bally65/Archimedes-Hand-/zero_robotic_arm_analysis.md

# Molty's Report: Zero Robotic Arm Project Analysis

## 1. Overview
The **Zero Robotic Arm** project is a sophisticated open-source robotic system. It features a complete stack including:
- **Mechanical Design**: SolidWorks models, STEP files, and 3D printing components.
- **Embedded Software**: STM32F407-based firmware using FreeRTOS and HAL.
- **Simulation**: MATLAB/Simulink for kinematics and control.
- **AI/ML**: A Deep Reinforcement Learning (DRL) implementation using TD3 for end-effector position tracking.

## 2. Key Observations

### Embedded Logic (`robot_kinematics.c`)
- Implements **Inverse Kinematics** for a 6-DOF arm.
- Uses DH (Denavit-Hartenberg) parameters and symbolic derivation (likely from the Simulink files).
- Includes logic to map radian results to 0-360 degree ranges and handle joint limits.
- **Insight**: The inverse kinematics solve for $\theta_3$ first (using PX, PY, PZ), then $\theta_2$, $\theta_1$, and finally the orientation ($\theta_5, \theta_4, \theta_6$).

### Deep Learning (`Deep_LR`)
- Uses **TD3 (Twin Delayed DDPG)** via Stable-Baselines3.
- Custom Gymnasium environment (`RobotArmEnv`) integrated with **MuJoCo** for physics.
- The observation space (24 dimensions) includes relative position, joint angles, velocities, previous torque, and end-effector velocity.
- Reward function is complex, rewarding distance improvement, phase thresholds (up to 10,000 pts), and punishing collisions or excessive speed.

### Hardware Infrastructure
- Target MCU: **STM32F407VET6**.
- Communication: CAN bus for motor control, USART for telemetry/MQTT (via ESP8266).
- Motor Types: ZDT X35/X42 series with planetary reduction.

## 3. Potential for Singularity Project Integration
The Singularity Project's Pattern Recognition (Model V3) could be adapted to:
1.  **Fault Prediction**: Predict motor failures or joint drift based on torque/velocity patterns.
2.  **Advanced Path Planning**: Replace or augment the DRL agent with the Singularity V3 architecture for more stable high-speed tracking.
3.  **Torque Optimization**: Apply the 4WD torque distribution research to the robotic joints to minimize energy consumption.

## 4. Current Environment Status
- **Cloned**: Successfully in `zero_robotic_arm/`.
- **System**: Python 3.12 (Native), Go 1.22.
- **Missing**: `gymnasium`, `mujoco`, and `stable-baselines3` are not in the default or venv paths.
- **Action Required**: If Bally wishes to run the training, I need to properly initialize a Python environment with these dependencies.

---
*Report generated by Molty* 🧐
