bally65/Archimedes-Hand-/5. Deep_LR/training_trend.png

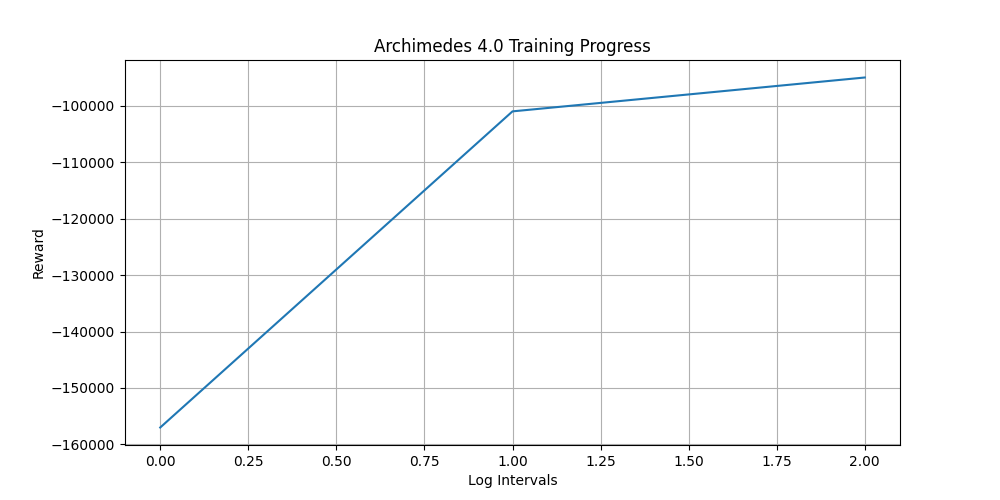
5. Deep_LR/training_trend.png
