bally65/Archimedes-Hand-/BOM.xlsx

序号 | 物料名称 | 规格 | 数量 | 备注 | 链接
1 | 行星减速器 | 51：1减速PLZ | 2 |  | https://item.taobao.com/item.htm?id=526104907428
2 | 行星减速器 | 27：1减速 输入6轴径 铣扁1mm | 1 |  | https://item.taobao.com/item.htm?id=526104907428
3 | STM32F407开发板 |  | 1 | 要求芯片为STM32F407，支持CAN协议 | https://item.taobao.com/item.htm?id=681246792404
4 | 42步进电机 | 42-40 身长40 | 2 |  | https://item.taobao.com/item.htm?id=673302946671&skuId=5032954871244
5 | 42行星减速步进电机 | 42HS4013 身长40 减速比50 | 1 |  | https://item.taobao.com/item.htm?id=21034340111&sku_properties=1627207%3A33214301305
6 | 35步进电机 | 35-28 | 1 |  | https://item.taobao.com/item.htm?id=723690490192
7 | 35行星减速步进电机 | 35-26 减速比51 | 2 |  | https://item.taobao.com/item.htm?id=581976167345
8 | 42步进电机驱动器 |  | 3 | 本项目目前仅支持张大头驱动器，需购买CAN协议模块 | https://item.taobao.com/item.htm?id=736578173538
9 | 35步进电机驱动器 |  | 3 | 本项目目前仅支持张大头驱动器，需购买CAN协议模块 | https://item.taobao.com/item.htm?id=736578173538
10 | 圆锥滚子轴承 | 20*37*12 | 1 |  | https://detail.tmall.com/item.htm?id=616787169746
11 | 十字扁平头螺丝 | M3*8 | 32 |  | https://detail.tmall.com/item.htm?id=641493636015
12 | 内六角螺丝圆柱头螺栓 | M5*14 | 4 |  | https://detail.tmall.com/item.htm?id=40189700729
13 | 内六角螺丝圆柱头螺栓 | M4*14 | 4 |  | https://detail.tmall.com/item.htm?id=40189700729
14 | 六角螺帽 | M5 | 4 |  | https://detail.tmall.com/item.htm?detail_redpacket_pop=true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
15 | 六角螺帽 | M3 | 2 |  | https://detail.tmall.com/item.htm?id=549640610734
16 | 土八热熔螺母 | M2*2*3 | 10 |  | https://detail.tmall.com/item.htm?id=809364062256
17 | 3M同步轮 | 3M25齿 孔8 宽11 | 2 |  | https://item.taobao.com/item.htm?id=739009813395
18 | 3M同步轮 | 3M25齿 孔5 宽11 | 3 |  | https://item.taobao.com/item.htm?id=739009813395
19 | 3M同步轮 | 3M25齿 孔6 宽11 | 1 |  | https://item.taobao.com/item.htm?id=739009813395
20 | 3M同步带 | 3M-长171-宽10 | 1 | 任意同步带淘宝店定制即可
21 | 3M同步带 | 3M-长177-宽10 | 2 | 任意同步带淘宝店定制即可
24 | 联轴器 | 外径28mm抱紧式联轴器 孔径8mm | 5 |  | https://detail.tmall.com/item.htm?id=667472622255
25 | 限位开关 | KW11-3Z-A | 3 |  | https://item.taobao.com/item.htm?id=630808292950
26 | 限位开关 | KW11-3Z-B | 2 |  | https://item.taobao.com/item.htm?id=630808292950
27 | 十字扁平头螺丝 | M2*8 | 10 |  | https://detail.tmall.com/item.htm?id=641493636015
28 | 张大头 步进闭环拓展板 |  | 1 |  | https://item.taobao.com/item.htm?ft=t&id=838884896678
29 | 不锈钢圆头螺丝 | M3*28 | 4 | 用来固定驱动器与35行星减速步进电机 | https://detail.tmall.com/item.htm?id=37753866337
30 | 内六角螺丝圆柱头螺栓 | M3*14 | 1 |  | https://detail.tmall.com/item.htm?id=40189700729
