bally65/Archimedes-Hand-/1. Model/3d_printing_all.3mf

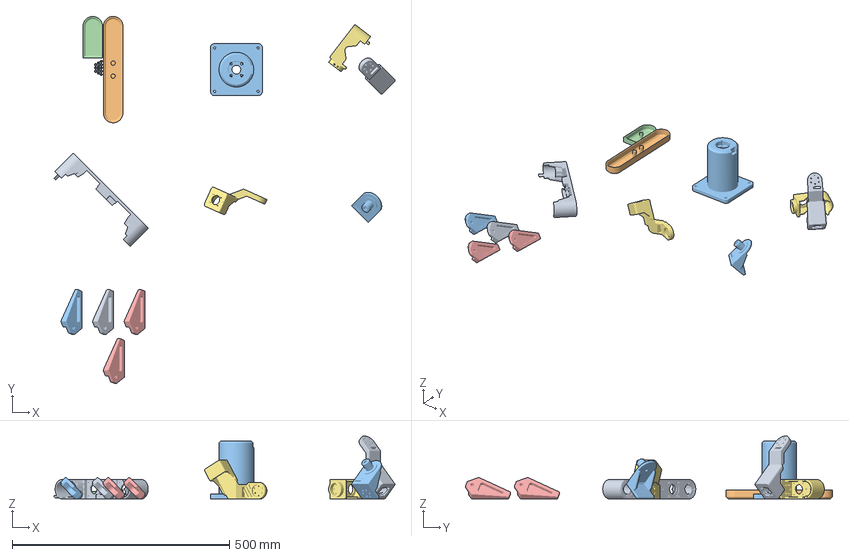
[picture p7: CAD file, 2026-02-07]
1. Model/3d_printing_all.3mf
785.0 x 845.2 x 145.0 mm
frame2.STEP
外壳1.step
frame0^ZERO_ARM.STEP
外壳2.STEP
底座固定爪^XG_Robot_Arm.STEP x 4
1mm垫片.STEP x 12
frame4.STEP
frame3.STEP
frame5.STEP
frame1.STEP
