bally65/Archimedes-Hand-/1. Model/STEP/单轴行星减速器35-38.step

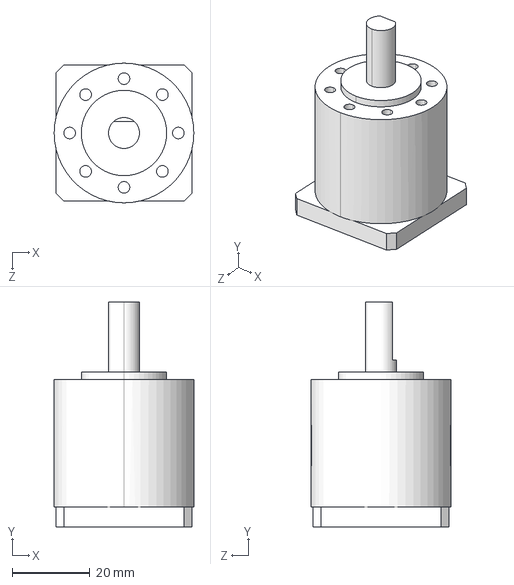
[picture p8: CAD file, 2026-02-07]
1. Model/STEP/单轴行星减速器35-38.step
36.0 x 58.0 x 36.0 mm
