bally65/Archimedes-Hand-/1. Model/STL/base_plate_optimized.stl

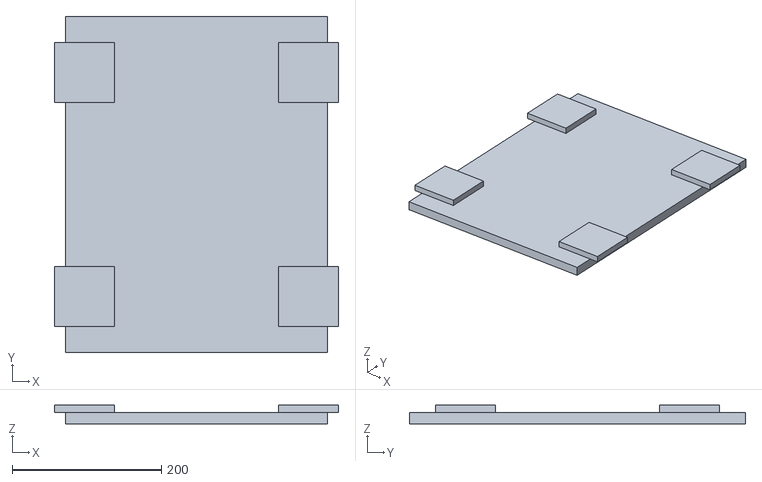
[picture p9: CAD file, 2026-02-11]
1. Model/STL/base_plate_optimized.stl
380.0 x 450.0 x 25.0
