bally65/Archimedes-Hand-/3. Simulink/model_v1.1/URDF_XG_Robot_Arm_Urdf_V1.1/meshes/link3.STL

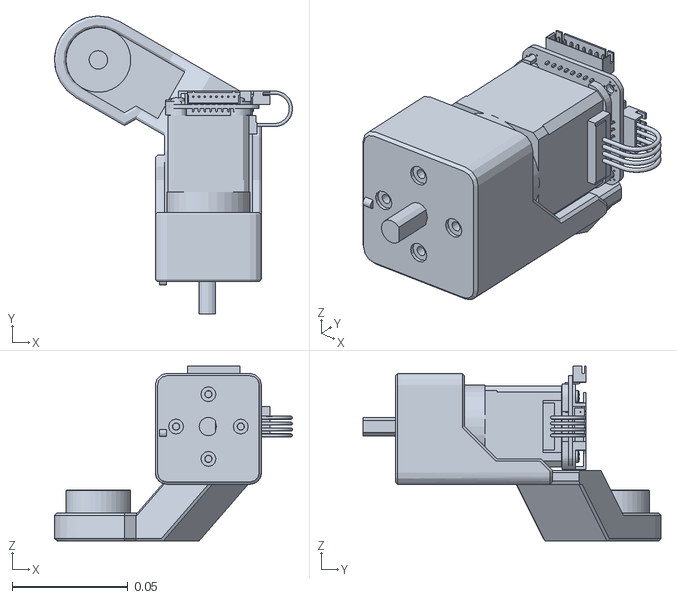
[picture p10: CAD file, 2026-02-07]
3. Simulink/model_v1.1/URDF_XG_Robot_Arm_Urdf_V1.1/meshes/link3.STL
0.103 x 0.129 x 0.0757
