bally65/Archimedes-Hand-/3. Simulink/model_v1.1/URDF同步轮M3-05.SLDPRT

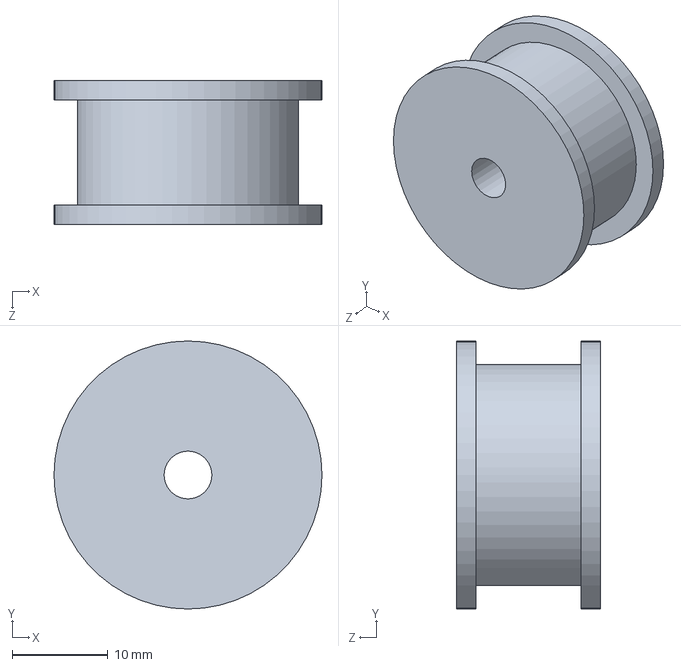
[picture p11: CAD file, 2026-02-07]
3. Simulink/model_v1.1/URDF同步轮M3-05.SLDPRT
28.0 x 28.0 x 15.0 mm
