bally65/Archimedes-Hand-/3. Simulink/URDF_XG_Robot_Arm_Urdf_V1_1/meshes/ee_link.STL

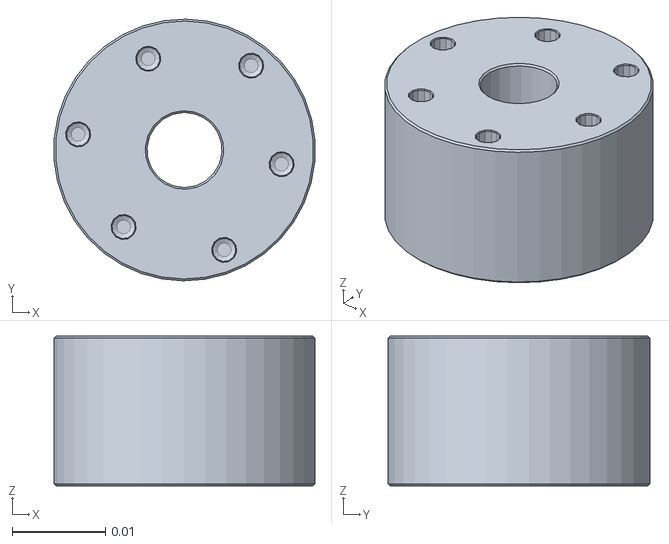
[picture p12: CAD file, 2026-02-07]
3. Simulink/URDF_XG_Robot_Arm_Urdf_V1_1/meshes/ee_link.STL
0.0279 x 0.028 x 0.016
