bally65/Archimedes-Hand-/1. Model/STEP/限位开关_按下_长柄.step

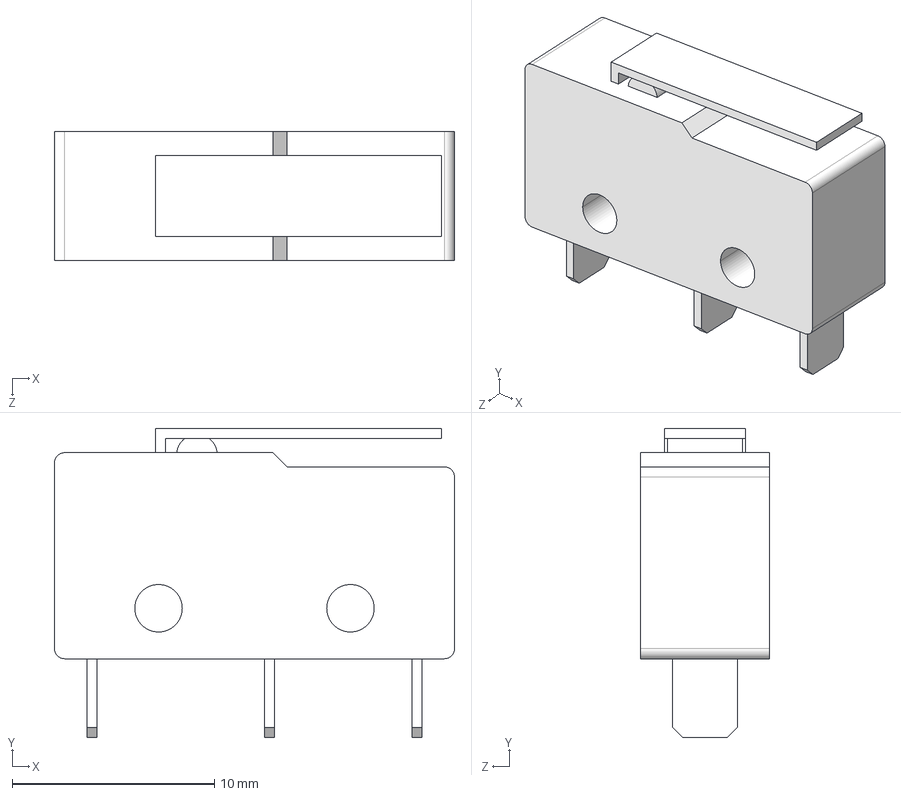
[picture p13: CAD file, 2026-02-07]
1. Model/STEP/限位开关_按下_长柄.step
19.8 x 15.3 x 6.40 mm
