bally65/Archimedes-Hand-/3. Simulink/model_v1.1/URDF_XG_Robot_Arm_Urdf_V1.1/meshes/link1.STL

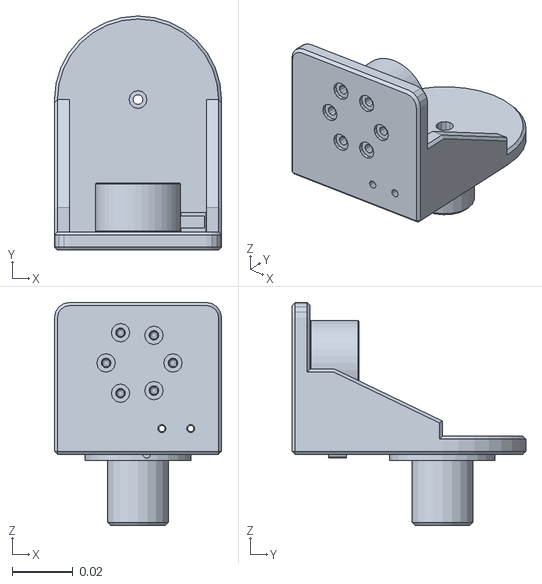
[picture p14: CAD file, 2026-02-07]
3. Simulink/model_v1.1/URDF_XG_Robot_Arm_Urdf_V1.1/meshes/link1.STL
0.055 x 0.077 x 0.0734
