bally65/Archimedes-Hand-/3. Simulink/model_v1.1/URDFframe5.SLDPRT

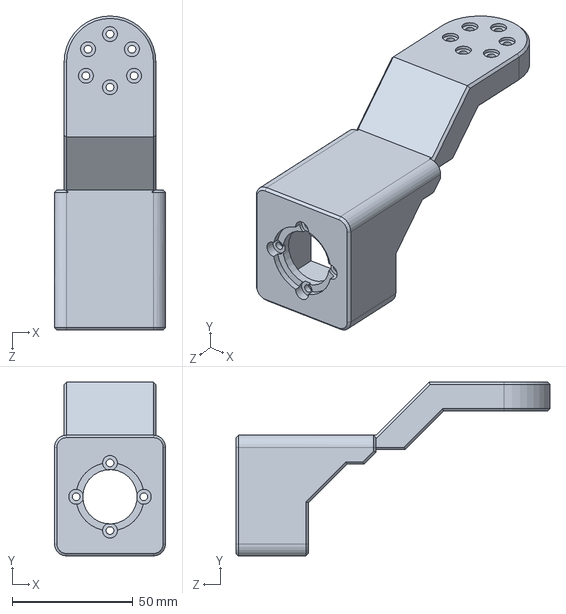
[picture p15: CAD file, 2026-02-07]
3. Simulink/model_v1.1/URDFframe5.SLDPRT
46.0 x 72.0 x 130.0 mm
