bally65/Archimedes-Hand-/3. Simulink/URDF_XG_Robot_Arm_Urdf_V1_1/meshes/link4.STL

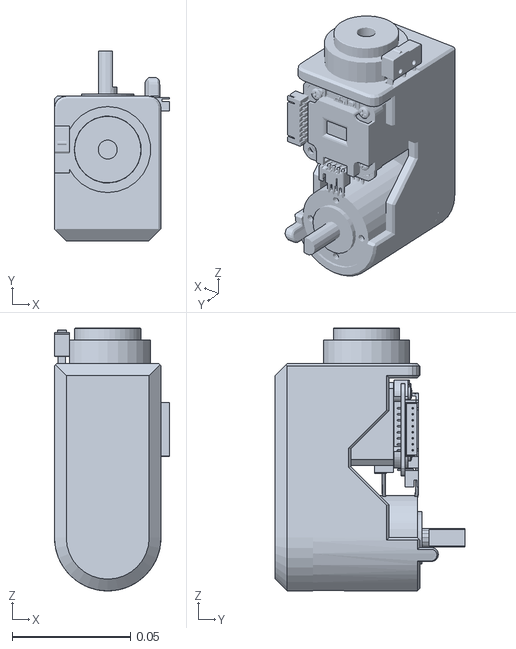
[picture p16: CAD file, 2026-02-07]
3. Simulink/URDF_XG_Robot_Arm_Urdf_V1_1/meshes/link4.STL
0.0487 x 0.08 x 0.111
