bally65/Archimedes-Hand-/1. Model/STL/base_plate.stl

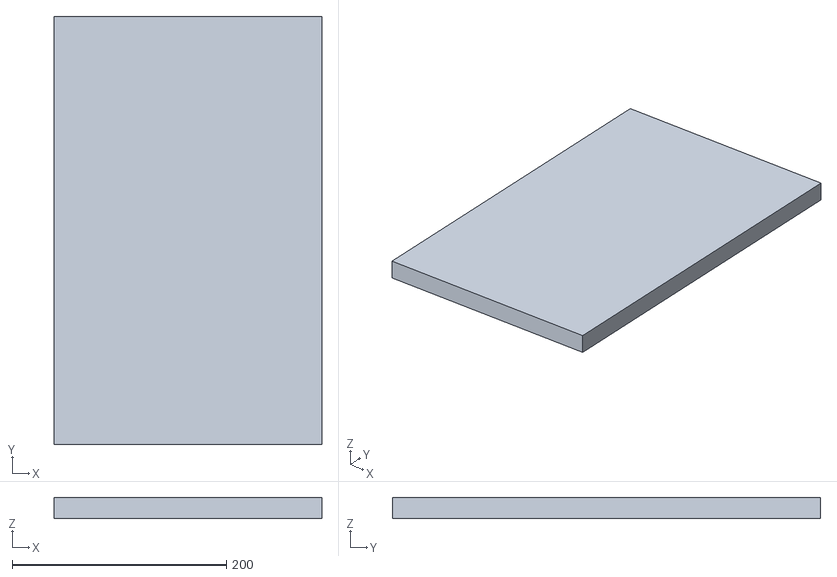
[picture p17: CAD file, 2026-02-08]
1. Model/STL/base_plate.stl
250.0 x 400.0 x 20.0
