bally65/Archimedes-Hand-/3. Simulink/model_v1.1/URDF外壳2.SLDPRT

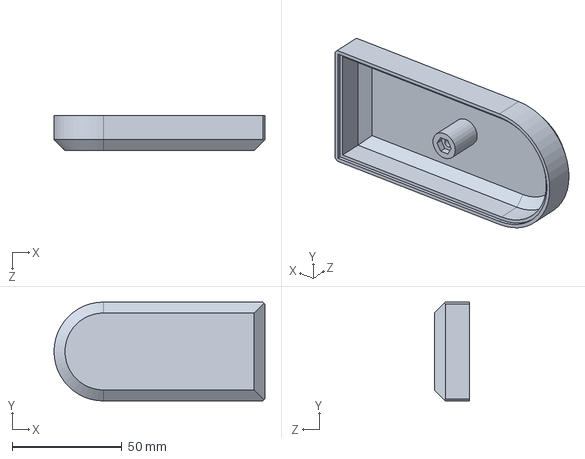
[picture p18: CAD file, 2026-02-07]
3. Simulink/model_v1.1/URDF外壳2.SLDPRT
96.0 x 45.0 x 16.0 mm
