bally65/Archimedes-Hand-/3. Simulink/URDF_XG_Robot_Arm_Urdf_V1_1/meshes/link5.STL

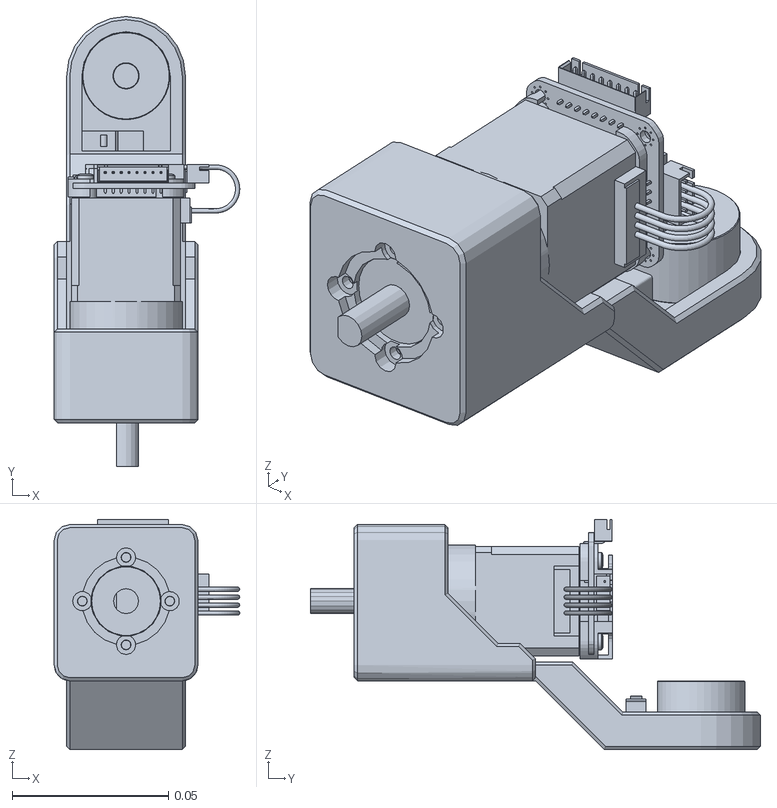
[picture p19: CAD file, 2026-02-07]
3. Simulink/URDF_XG_Robot_Arm_Urdf_V1_1/meshes/link5.STL
0.0594 x 0.144 x 0.0737
