bally65/Archimedes-Hand-/1. Model/STEP/frame5.step

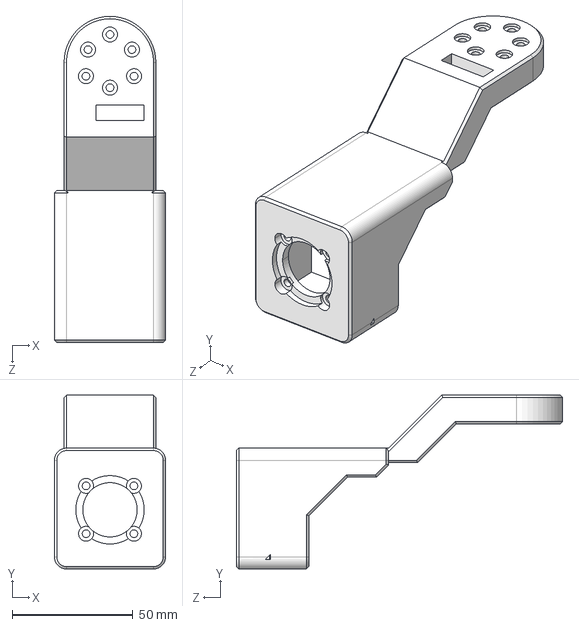
[picture p20: CAD file, 2026-02-07]
1. Model/STEP/frame5.step
46.0 x 72.0 x 135.0 mm
