bally65/Archimedes-Hand-/3. Simulink/model_v1.1/URDFframe4.SLDPRT

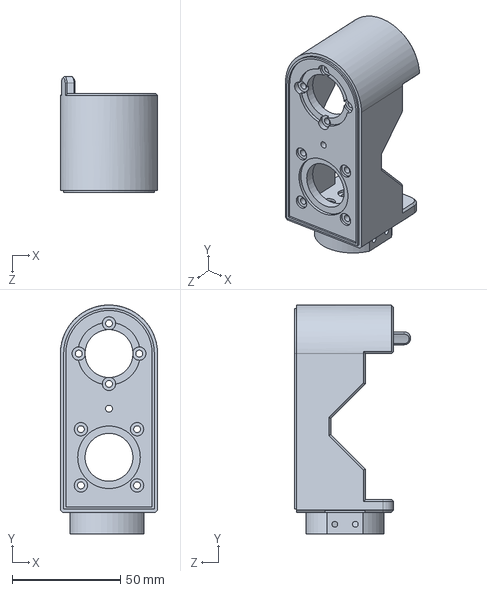
[picture p21: CAD file, 2026-02-07]
3. Simulink/model_v1.1/URDFframe4.SLDPRT
45.0 x 106.0 x 53.9 mm
