bally65/Archimedes-Hand-/1. Model/STEP/1mm垫片.STEP

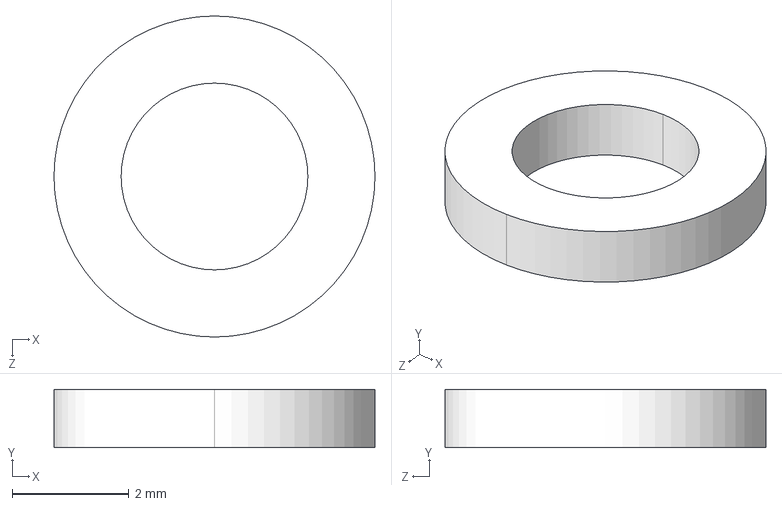
[picture p22: CAD file, 2026-02-07]
1. Model/STEP/1mm垫片.STEP
5.50 x 1.00 x 5.50 mm
