bally65/Archimedes-Hand-/3. Simulink/model_v1.1/URDFframe2.SLDPRT

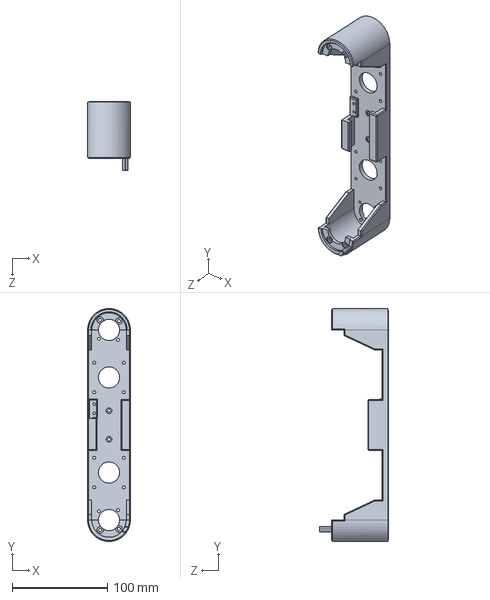
[picture p23: CAD file, 2026-02-07]
3. Simulink/model_v1.1/URDFframe2.SLDPRT
45.0 x 245.0 x 73.0 mm
