bally65/Archimedes-Hand-/1. Model/STEP/外壳2.step

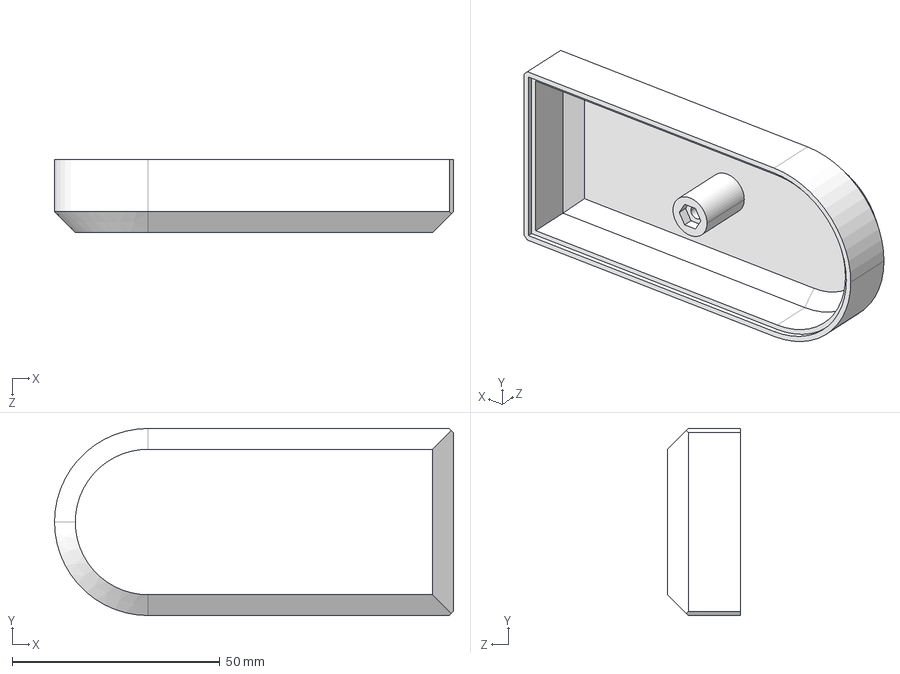
[picture p24: CAD file, 2026-02-07]
1. Model/STEP/外壳2.step
96.0 x 45.0 x 17.5 mm
