bally65/Archimedes-Hand-/3. Simulink/model_v1.1/URDF热熔螺母.SLDPRT

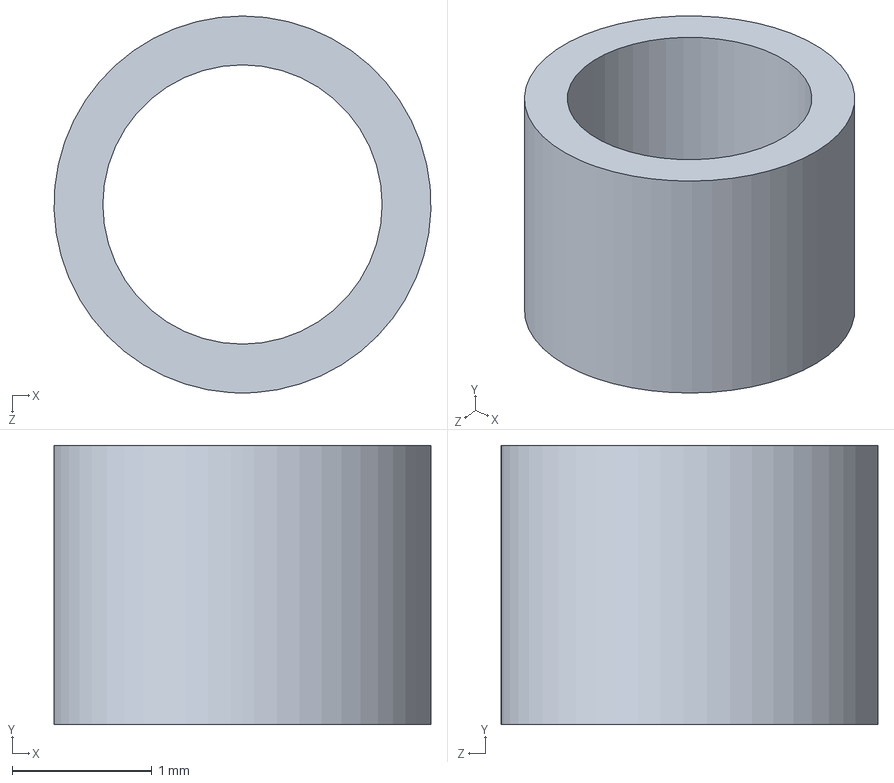
[picture p25: CAD file, 2026-02-07]
3. Simulink/model_v1.1/URDF热熔螺母.SLDPRT
2.70 x 2.00 x 2.70 mm
