bally65/Archimedes-Hand-/1. Model/STEP/底座固定爪.step

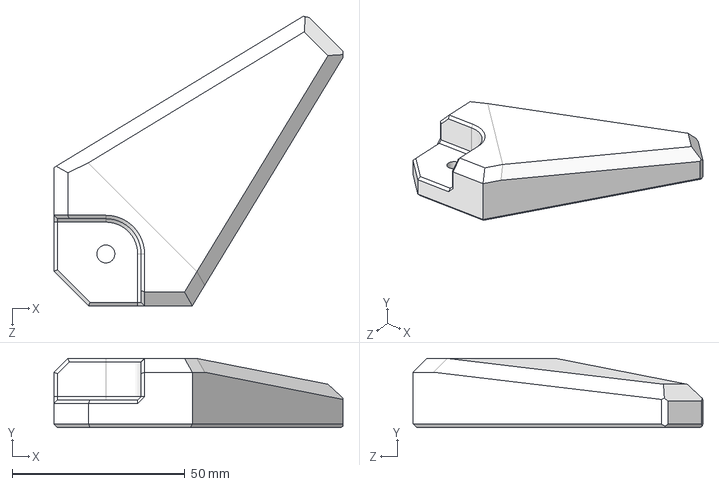
[picture p26: CAD file, 2026-02-07]
1. Model/STEP/底座固定爪.step
83.6 x 20.0 x 83.8 mm
