bally65/Archimedes-Hand-/1. Model/STEP/限位开关_按下_0.8mm.step

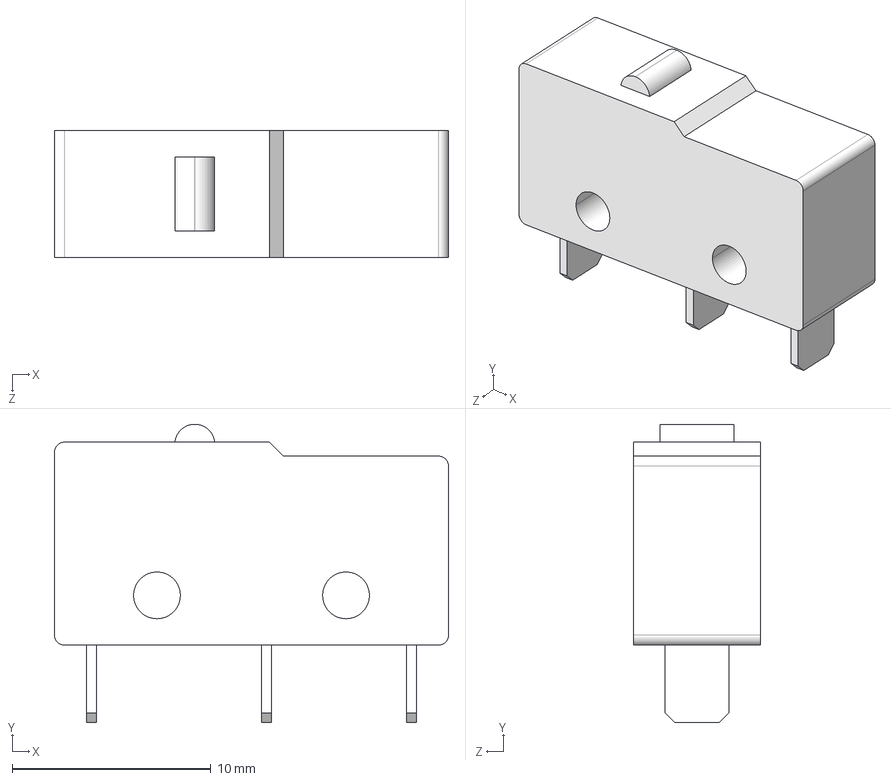
[picture p27: CAD file, 2026-02-07]
1. Model/STEP/限位开关_按下_0.8mm.step
19.8 x 15.0 x 6.40 mm
