bally65/Archimedes-Hand-/1. Model/STEP/ZDT_X42_L40Motor.step

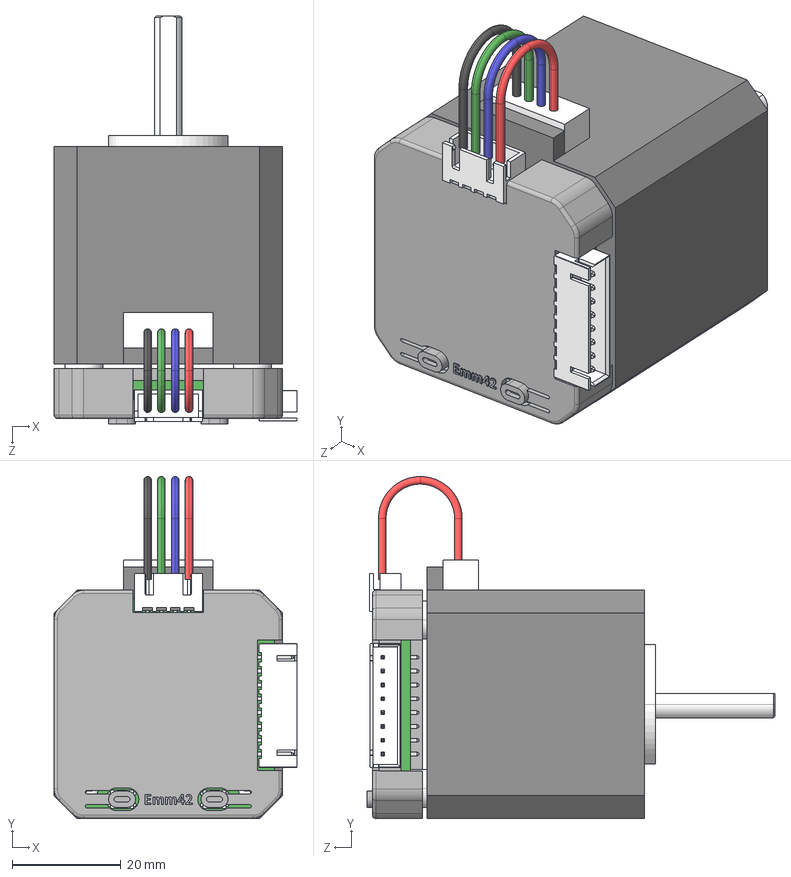
[picture p29: CAD file, 2026-02-07]
1. Model/STEP/ZDT_X42_L40Motor.step
44.7 x 62.9 x 75.0 mm
ts-1145a-b-a_White.step.STEP x 2
User_Library-XH2_54-4P-AW.step.STEP
XH2.54-8P_H-0.step.STEP
Extruded.step.STEP
Extruded-1.step.STEP
42_STEPPER_MOTOR.STEP
SHIM_3x7x3.STEP x 4
M3x6mm_Phillips.STEP x 4
ZDT_X42_V1.2.STEP
WIRE_2.54.STEP
