bally65/Archimedes-Hand-/3. Simulink/model_v1.1/URDF外壳1.SLDPRT

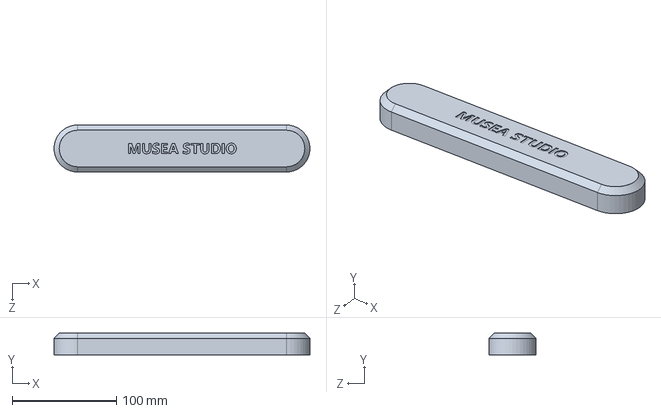
[picture p30: CAD file, 2026-02-07]
3. Simulink/model_v1.1/URDF外壳1.SLDPRT
245.0 x 21.0 x 45.0 mm
