bally65/Archimedes-Hand-/1. Model/STEP/双轴行星减速器36-38.step

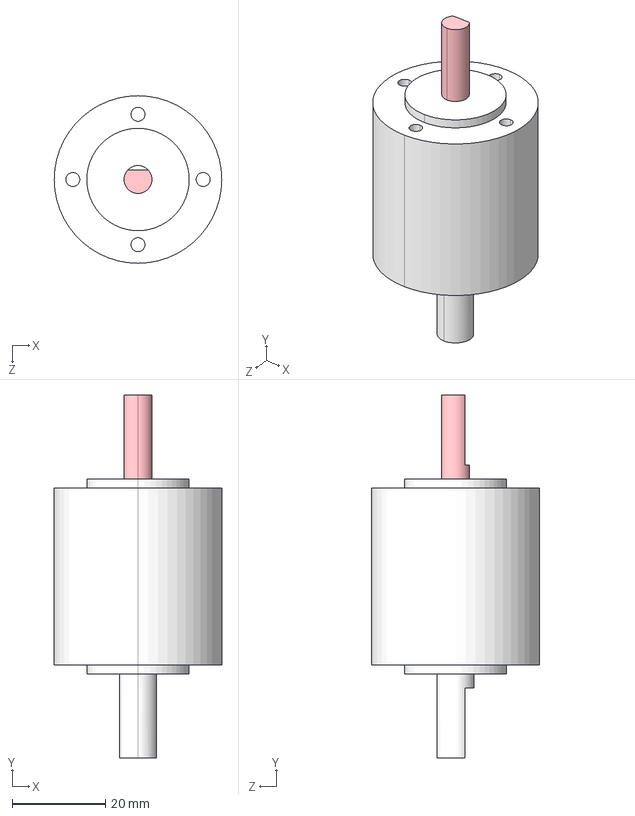
[picture p31: CAD file, 2026-02-07]
1. Model/STEP/双轴行星减速器36-38.step
36.0 x 78.0 x 36.0 mm
