bally65/Archimedes-Hand-/3. Simulink/model_v1.1/URDF单轴行星减速器35-38.SLDPRT

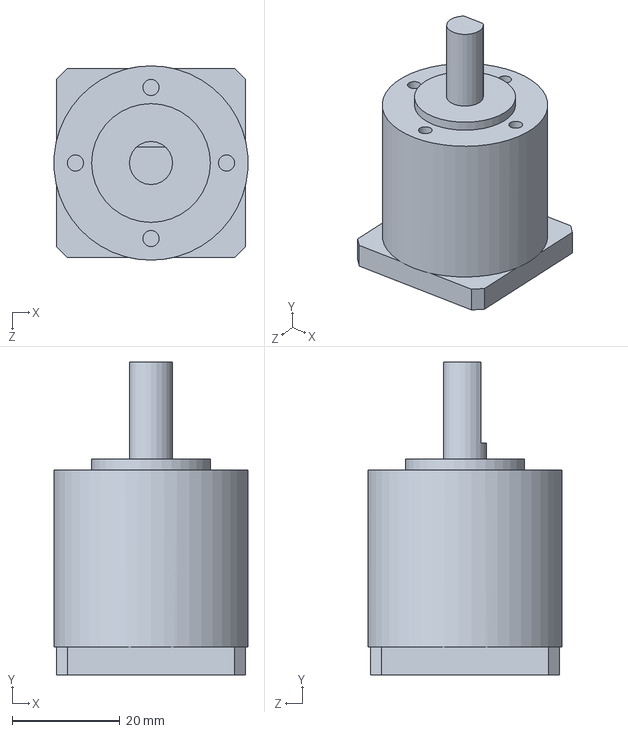
[picture p32: CAD file, 2026-02-07]
3. Simulink/model_v1.1/URDF单轴行星减速器35-38.SLDPRT
35.9 x 58.0 x 36.0 mm
