bally65/Archimedes-Hand-/1. Model/STEP/frame0^ZERO_ARM.STEP

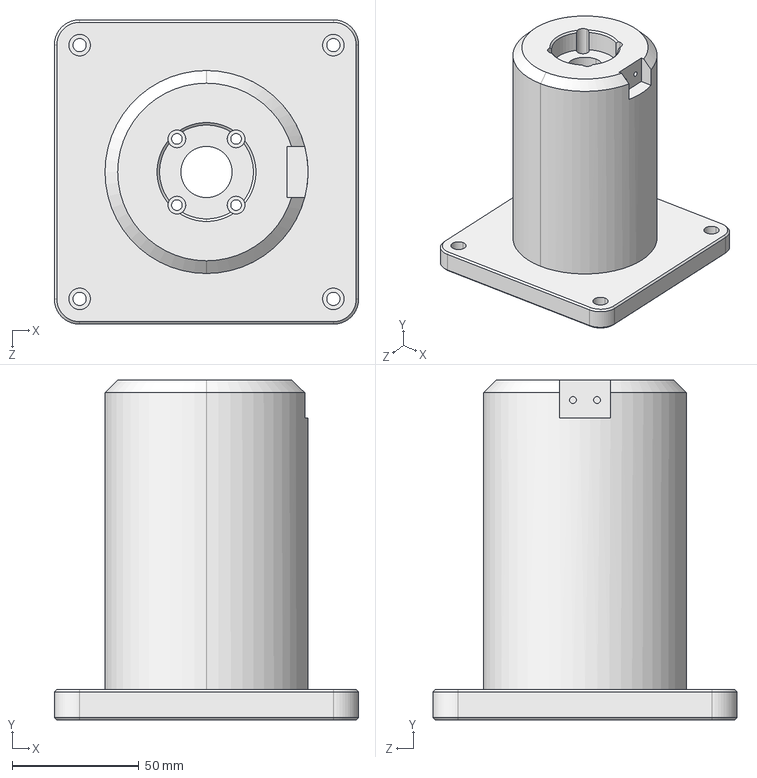
[picture p33: CAD file, 2026-02-07]
1. Model/STEP/frame0^ZERO_ARM.STEP
120.0 x 134.0 x 120.0 mm
