bally65/Archimedes-Hand-/1. Model/STEP/42XG二级减速.step

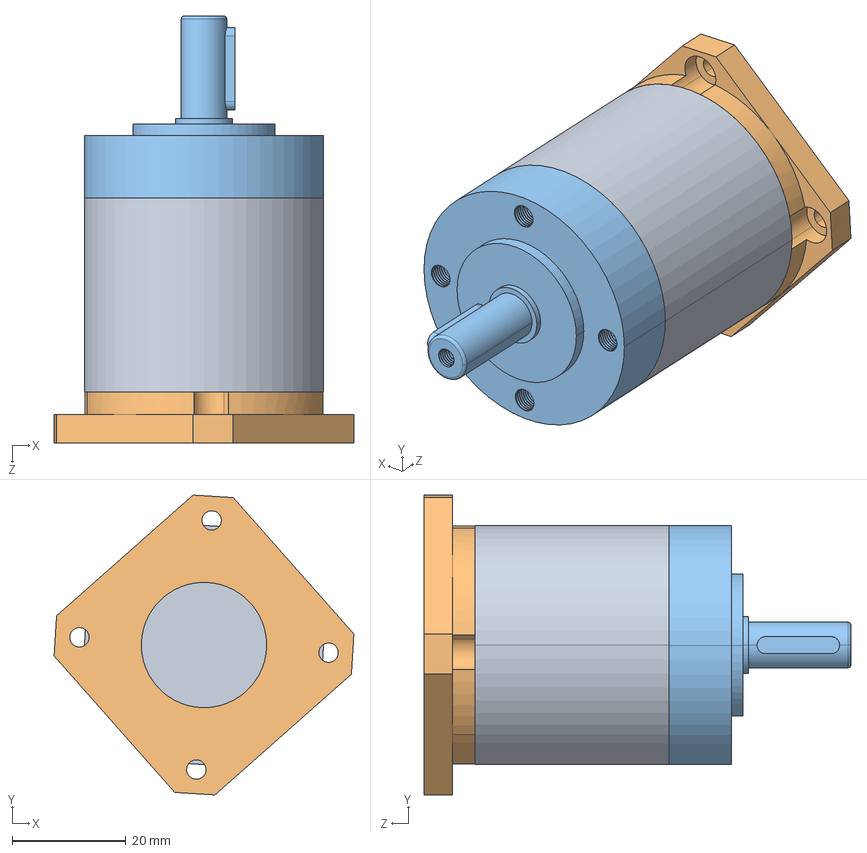
[picture p34: CAD file, 2026-02-07]
1. Model/STEP/42XG二级减速.step
52.7 x 52.7 x 75.0 mm
42XG____.STEP
42XG______.STEP
42XG______-0.STEP
