bally65/Archimedes-Hand-/3. Simulink/model_v1.1/URDFframe3.SLDPRT

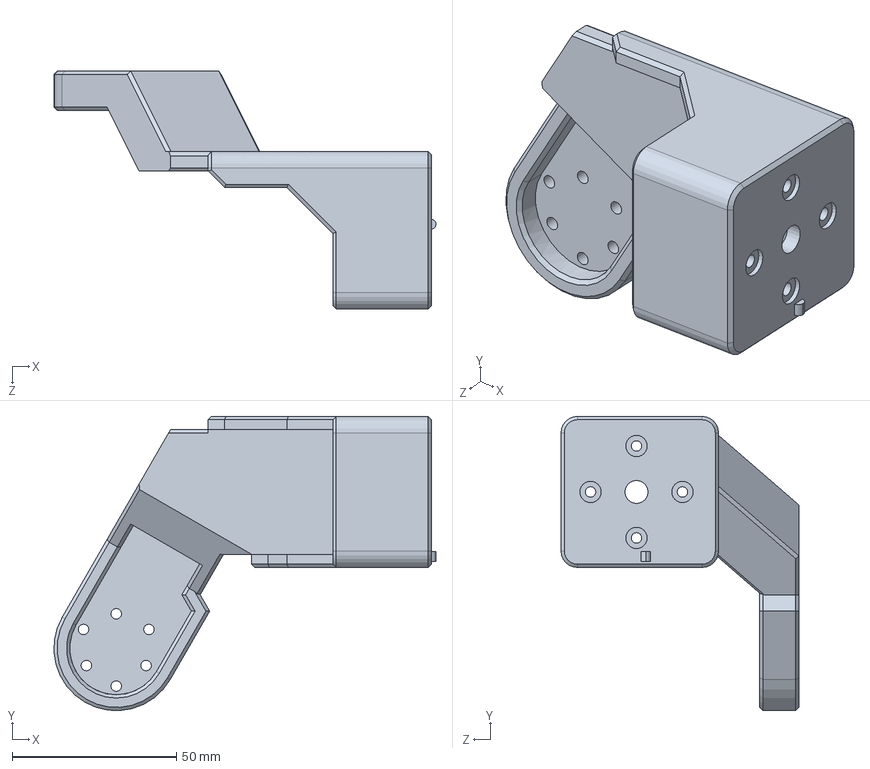
[picture p35: CAD file, 2026-02-07]
3. Simulink/model_v1.1/URDFframe3.SLDPRT
116.4 x 89.6 x 72.5 mm
