bally65/Archimedes-Hand-/1. Model/STEP/frame2.step

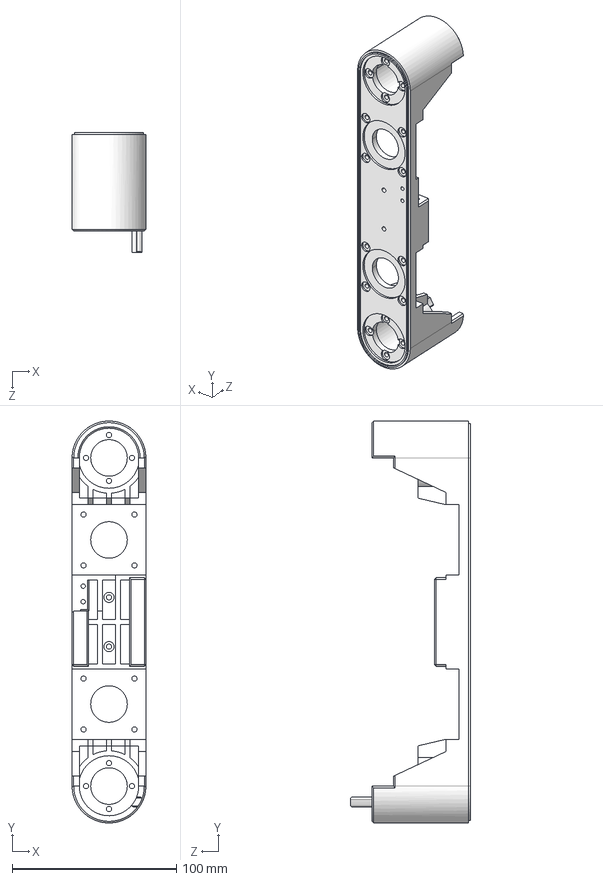
[picture p36: CAD file, 2026-02-07]
1. Model/STEP/frame2.step
45.0 x 245.0 x 73.0 mm
