bally65/Archimedes-Hand-/3. Simulink/model_v1.1/URDF双轴行星减速器36-38.SLDPRT

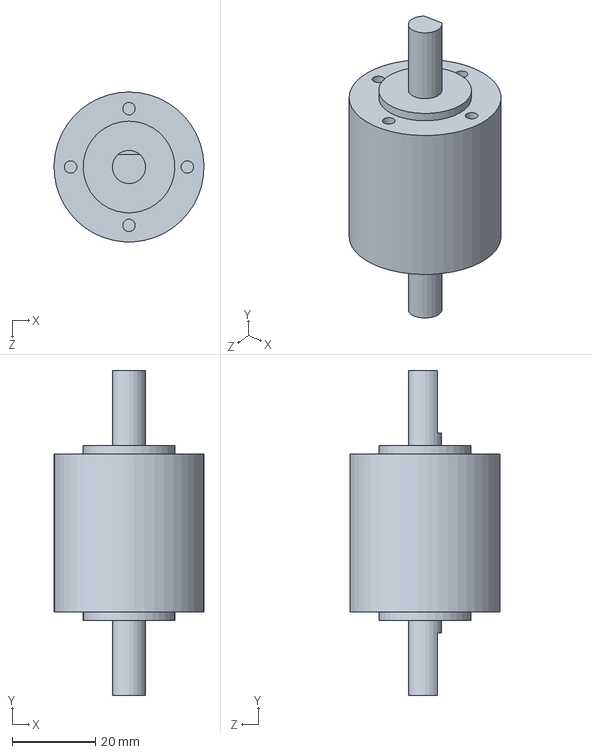
[picture p37: CAD file, 2026-02-07]
3. Simulink/model_v1.1/URDF双轴行星减速器36-38.SLDPRT
36.0 x 78.0 x 36.0 mm
