bally65/Archimedes-Hand-/3. Simulink/model_v1.1/URDFframe1.SLDPRT

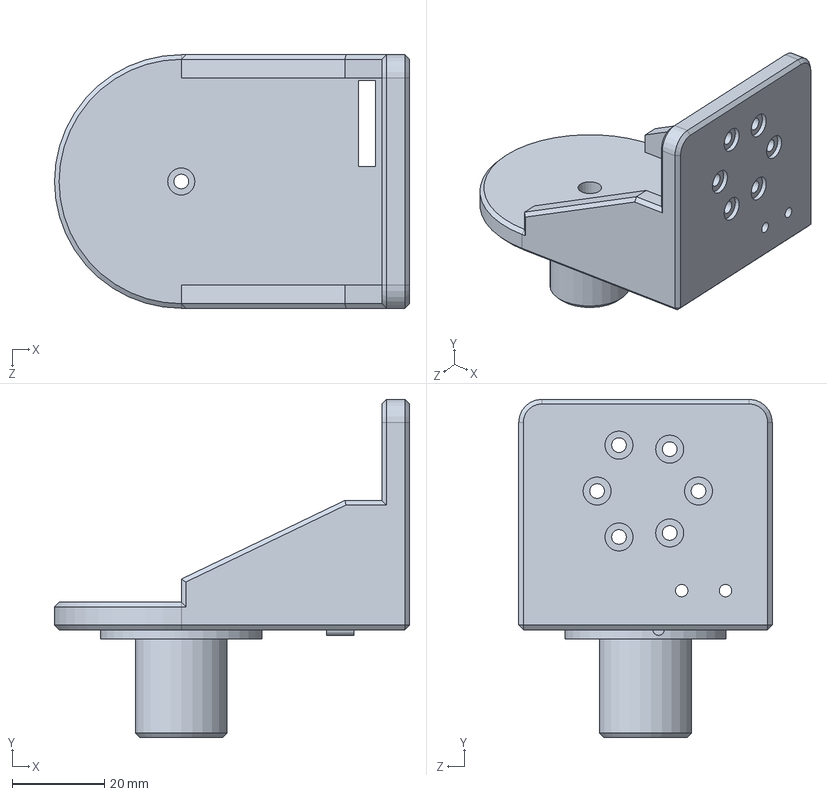
[picture p38: CAD file, 2026-02-07]
3. Simulink/model_v1.1/URDFframe1.SLDPRT
77.0 x 73.4 x 55.0 mm
