bally65/Archimedes-Hand-/1. Model/STEP/轴直径8mm_抱紧式联轴器(客户图）.step

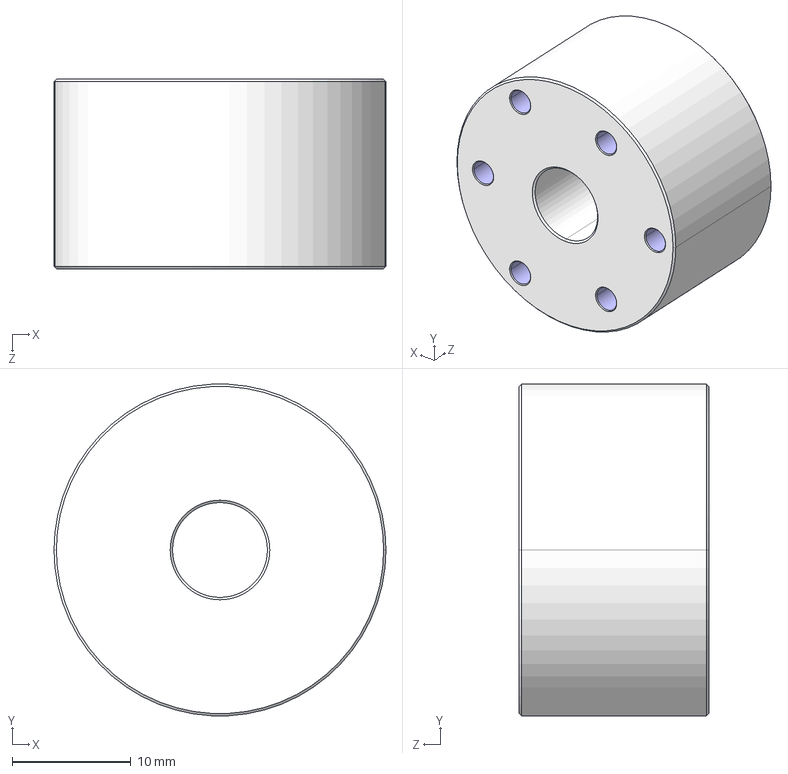
[picture p39: CAD file, 2026-02-07]
1. Model/STEP/轴直径8mm_抱紧式联轴器(客户图）.step
28.0 x 28.0 x 16.0 mm
