bally65/Archimedes-Hand-/1. Model/STEP/frame1.step

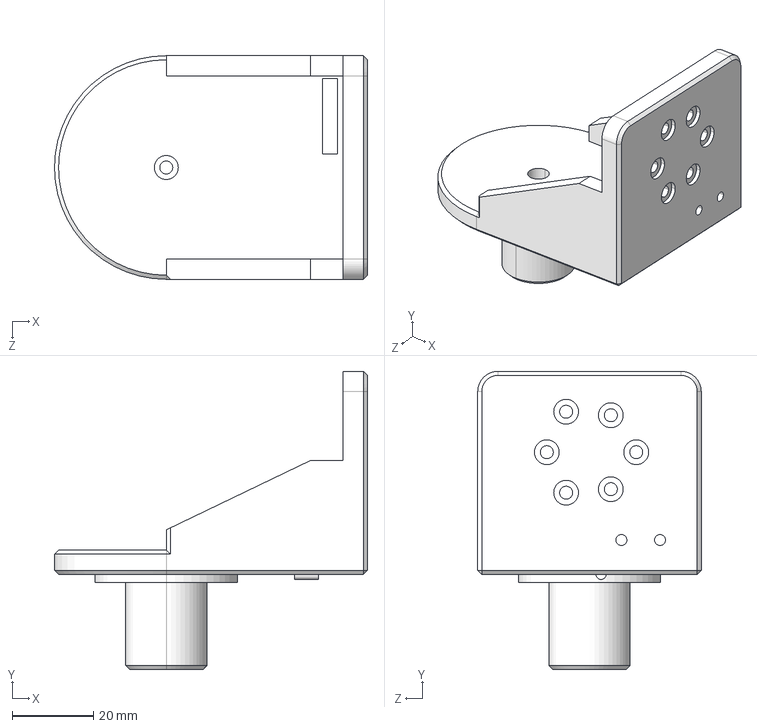
[picture p40: CAD file, 2026-02-07]
1. Model/STEP/frame1.step
77.0 x 73.4 x 55.0 mm
