bally65/Archimedes-Hand-/1. Model/STEP/手机夹具.step

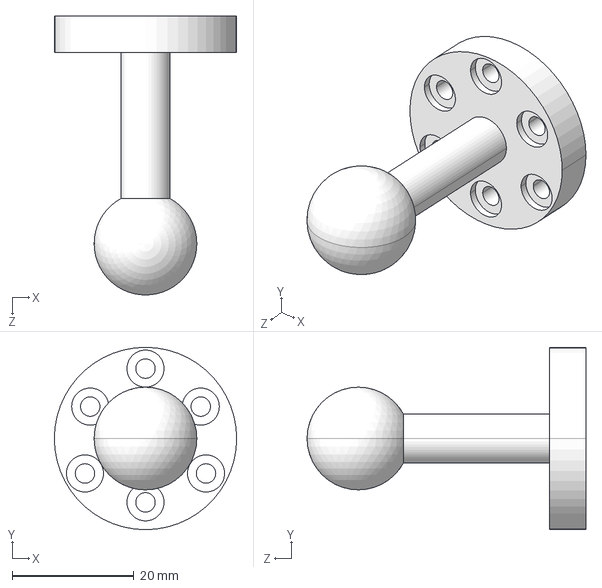
[picture p41: CAD file, 2026-02-07]
1. Model/STEP/手机夹具.step
30.0 x 30.0 x 45.9 mm
