bally65/Archimedes-Hand-/1. Model/STEP/ZDT_X35_L28Motor.step

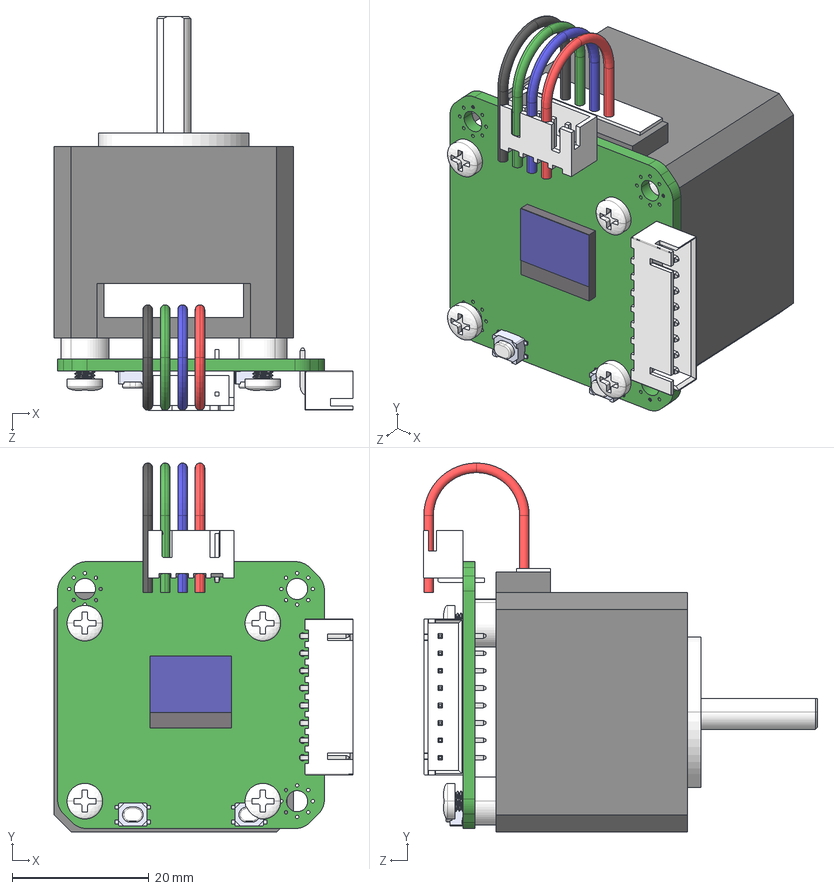
[picture p42: CAD file, 2026-02-07]
1. Model/STEP/ZDT_X35_L28Motor.step
43.7 x 53.9 x 57.6 mm
User_Library-XH2_54-4P-AW.step.STEP
ts-1145a-b-a_White.step.STEP x 2
Extruded.step.STEP
Extruded-1.step.STEP
XH2.54-8P_H-0.step.STEP
35_STEPPER_MOTOR.STEP
SHIM_3x7x3.STEP x 4
M3x6mm_Phillips.STEP x 4
WIRE_2.54.STEP
