bally65/Archimedes-Hand-/1. Model/STEP/frame3.step

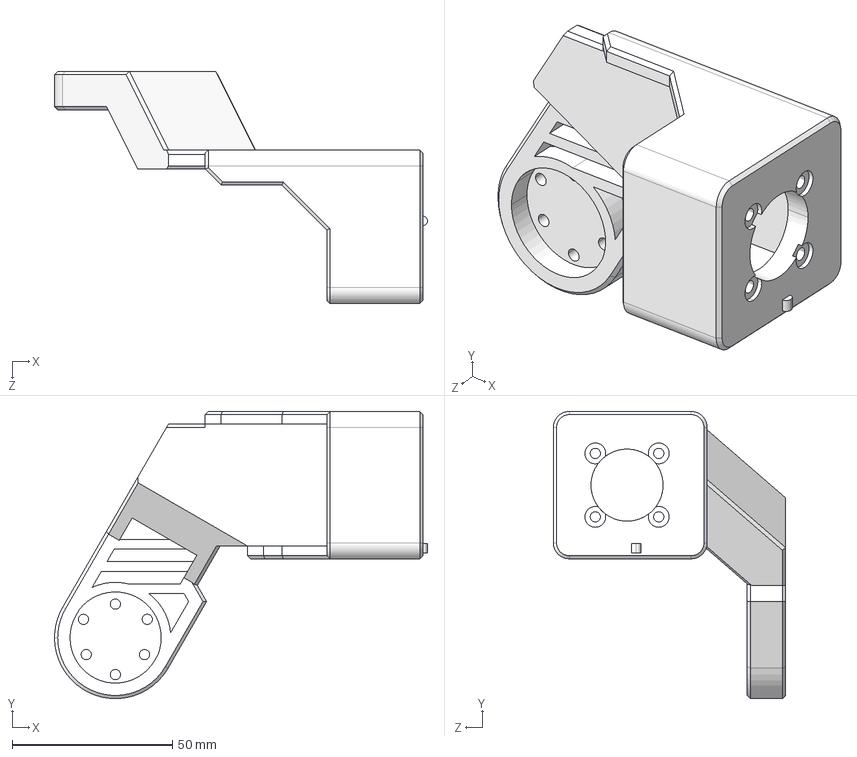
[picture p43: CAD file, 2026-02-07]
1. Model/STEP/frame3.step
116.4 x 89.6 x 72.5 mm
