bally65/Archimedes-Hand-/3. Simulink/model_v1.1/URDFZDT_X42_L40Motor.SLDASM

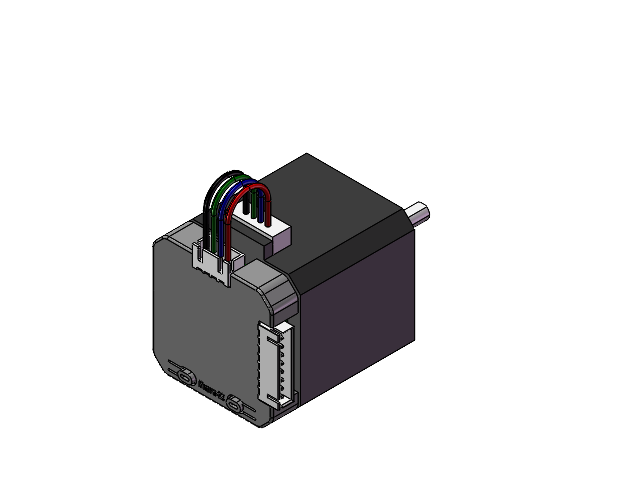
[picture p44: CAD file, 2026-02-07]
3. Simulink/model_v1.1/URDFZDT_X42_L40Motor.SLDASM
ts-1145a-b-a_White.step^Next.step_ZDT_X35_V1.2_PCB.step_ZDT_X35_L28Motor_URDFZDT_X35_L28Motor
User_Library-XH2_54-4P-AW.step^J6.step_ZDT_X35_V1.2_PCB.step_ZDT_X35_L28Motor_URDFZDT_X35_L28Motor
XH2.54-8P_H-0.step^XH2.54-8P_H.step_J3.step_ZDT_X35_V1.2_PCB.step_ZDT_X35_L28Motor_URDFZDT_X35_L28Motor
Extruded.step^6308926992.step_J1.step_ZDT_X35_V1.2_PCB.step_ZDT_X35_L28Motor_URDFZDT_X35_L28Motor
Extruded-1.step^6308926832.step_J1.step_ZDT_X35_V1.2_PCB.step_ZDT_X35_L28Motor_URDFZDT_X35_L28Motor
ts-1145a-b-a_White.step^Enter.step_ZDT_X35_V1.2_PCB.step_ZDT_X35_L28Motor_URDFZDT_X35_L28Motor
42_STEPPER_MOTOR^ZDT_X42_L40Motor_URDFZDT_X42_L40Motor
SHIM_3x7x3^ZDT_X35_L28Motor_URDFZDT_X35_L28Motor x 4
M3x6mm_Phillips^ZDT_X35_L28Motor_URDFZDT_X35_L28Motor x 4
ZDT_X42_V1.2^ZDT_X42_L40Motor_URDFZDT_X42_L40Motor
WIRE_2.54^ZDT_X35_L28Motor_URDFZDT_X35_L28Motor
