bally65/Archimedes-Hand-/3. Simulink/model_v1.1/URDF42XG二级减速.SLDASM

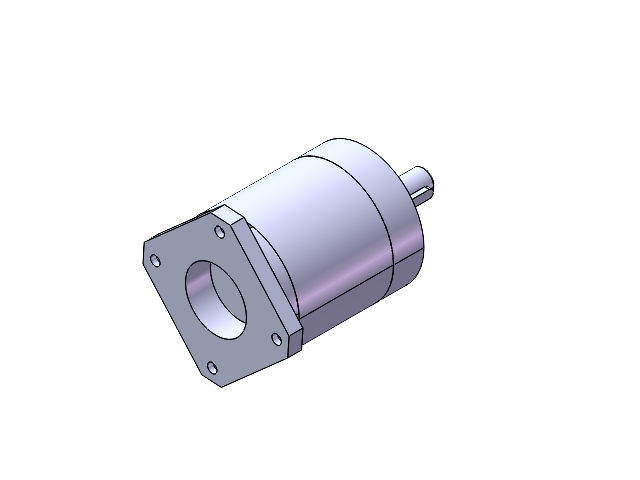
[picture p45: CAD file, 2026-02-07]
3. Simulink/model_v1.1/URDF42XG二级减速.SLDASM
42XG____^42XG二级减速_URDF42XG二级减速
42XG______^42XG二级减速_URDF42XG二级减速
42XG______-0^42XG二级减速_URDF42XG二级减速
