bally65/Archimedes-Hand-/(list of files, cad)

Other CAD files:
1. Model/STEP/同步轮M3-06.step
3. Simulink/model_v1.1/URDF_XG_Robot_Arm_Urdf_V1.1/meshes/link4.STL
1. Model/STEP/同步轮M3-05.step
3. Simulink/model_v1.1/URDF_XG_Robot_Arm_Urdf_V1.1/meshes/link5.STL
3. Simulink/model_v1.1/URDF同步轮M3-06.SLDPRT
3. Simulink/URDF_XG_Robot_Arm_Urdf_V1_1/meshes/link3.STL
5. Deep_LR/meshes/link1.STL
3. Simulink/URDF_XG_Robot_Arm_Urdf_V1_1/meshes/link1.STL
5. Deep_LR/meshes/link3.STL
3. Simulink/model_v1.1/URDF同步轮M3-08.SLDPRT
3. Simulink/model_v1.1/URDF限位开关_按下_0.8mm.SLDPRT
3. Simulink/model_v1.1/URDF限位开关_按下_长柄.SLDPRT
1. Model/STEP/外壳1.step
3. Simulink/model_v1.1/URDF双轴行星减速器36-47.SLDPRT
1. Model/STEP/同步轮M3-08.step
1. Model/STEP/frame4.step
3. Simulink/model_v1.1/URDF轴直径8mm_抱紧式联轴器(客户图）.SLDPRT
1. Model/STEP/热熔螺母.step
1. Model/42XG二级减速.SLDASM
1. Model/STL/screw_left.stl
1. Model/STL/screw_right.stl
1. Model/ZDT_X35_L28Motor.SLDASM
1. Model/ZDT_X42_L40Motor.SLDASM
1. Model/frame1.SLDPRT
1. Model/frame2.SLDPRT
1. Model/frame3.SLDPRT
1. Model/frame4.SLDPRT
1. Model/frame5.SLDPRT
1. Model/单轴行星减速器35-38.SLDPRT
1. Model/双轴行星减速器36-38.SLDPRT
1. Model/双轴行星减速器36-47.SLDPRT
1. Model/同步轮M3-05.SLDPRT
1. Model/同步轮M3-06.SLDPRT
1. Model/同步轮M3-08.SLDPRT
1. Model/外壳1.SLDPRT
1. Model/外壳2.SLDPRT
1. Model/底座固定爪.SLDPRT
1. Model/手机夹具.SLDPRT
1. Model/热熔螺母.SLDPRT
1. Model/轴直径8mm_抱紧式联轴器(客户图）.SLDPRT
1. Model/限位开关_按下_0.8mm.SLDPRT
1. Model/限位开关_按下_长柄.SLDPRT
5. Deep_LR/meshes/screw_left.stl
5. Deep_LR/meshes/screw_right.stl
simulation/screw_v1/constant/extendedFeatureEdgeMesh/screw_convexFeaturePts.obj
simulation/screw_v1/constant/extendedFeatureEdgeMesh/screw_edgeDirections.obj
simulation/screw_v1/constant/extendedFeatureEdgeMesh/screw_edgeMesh.obj
simulation/screw_v1/constant/extendedFeatureEdgeMesh/screw_externalEdges.obj
simulation/screw_v1/constant/triSurface/screw.stl
