bally65/Archimedes-Hand-/1. Model/installation_guide.md

# 零一造物_ZERO机械臂安装教程

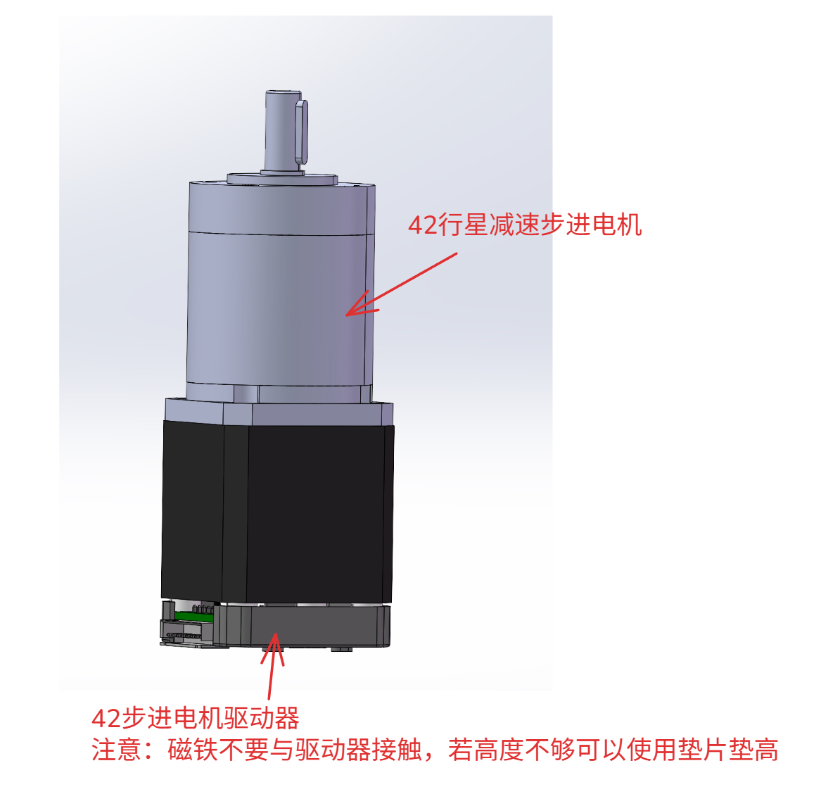
[picture p46: 4. Other/Images/install_01.jpg]


____

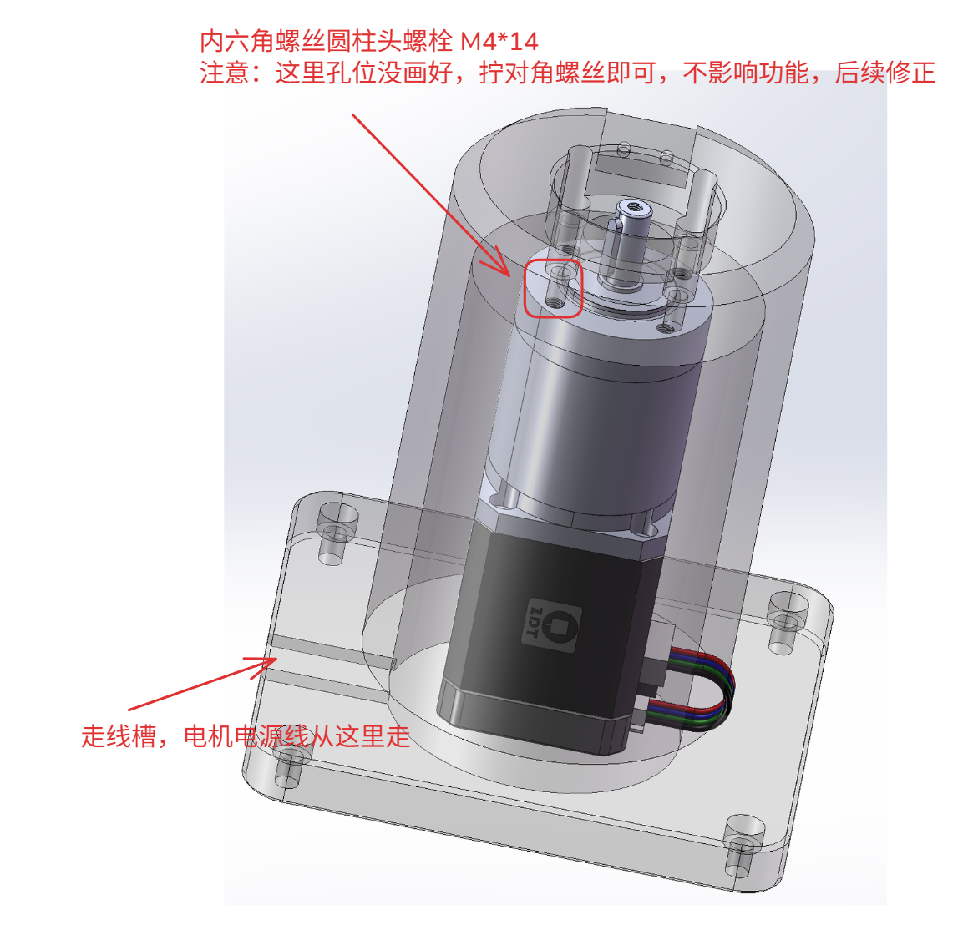
[picture p47: 4. Other/Images/install_02.jpg]


____

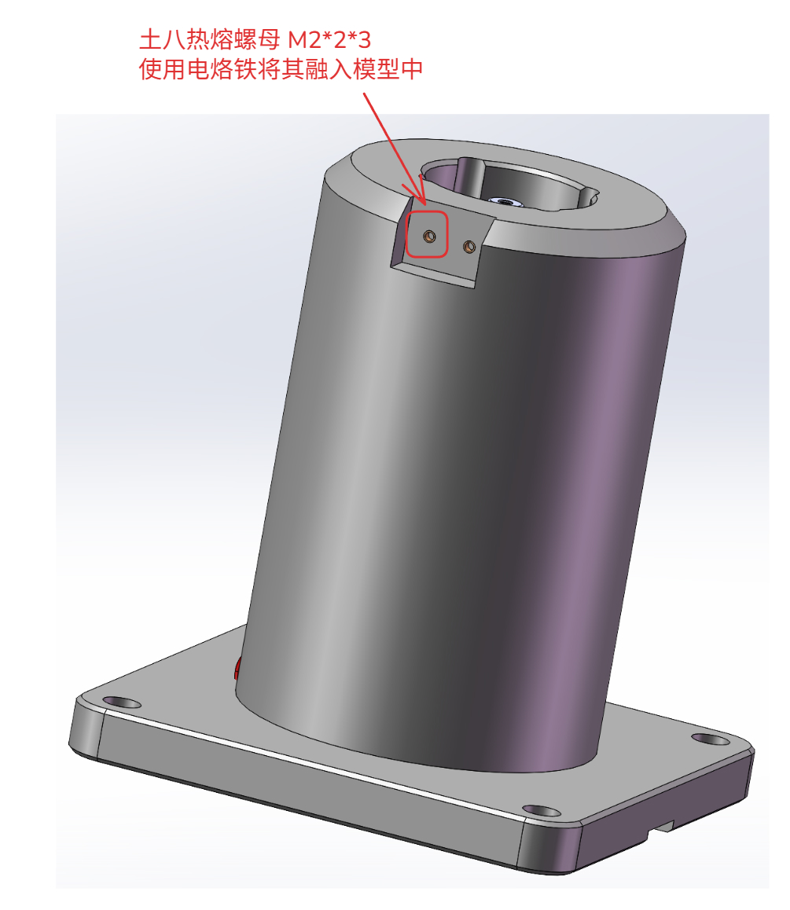
[picture p48: 4. Other/Images/install_03.jpg]


____

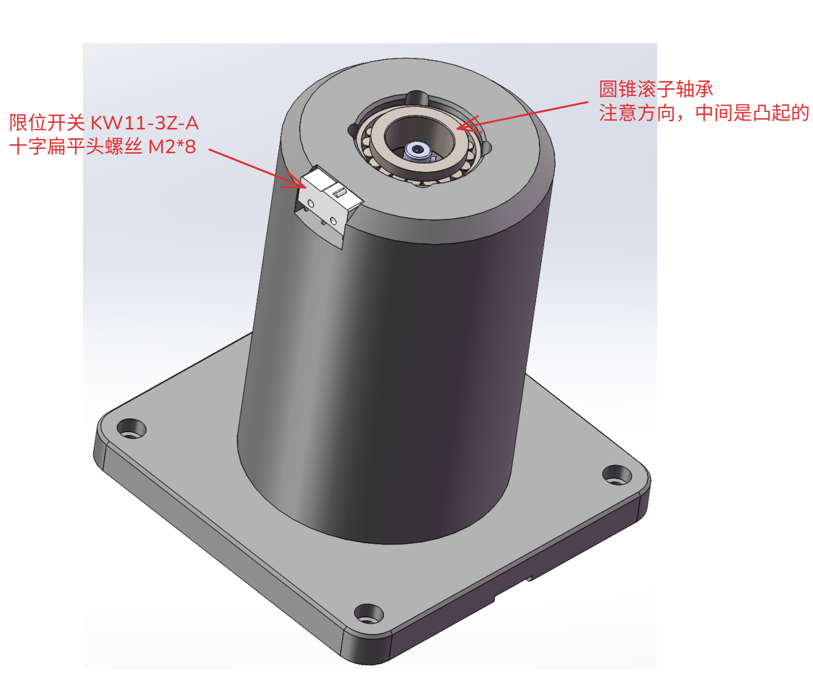
[picture p49: 4. Other/Images/install_04.jpg]


____

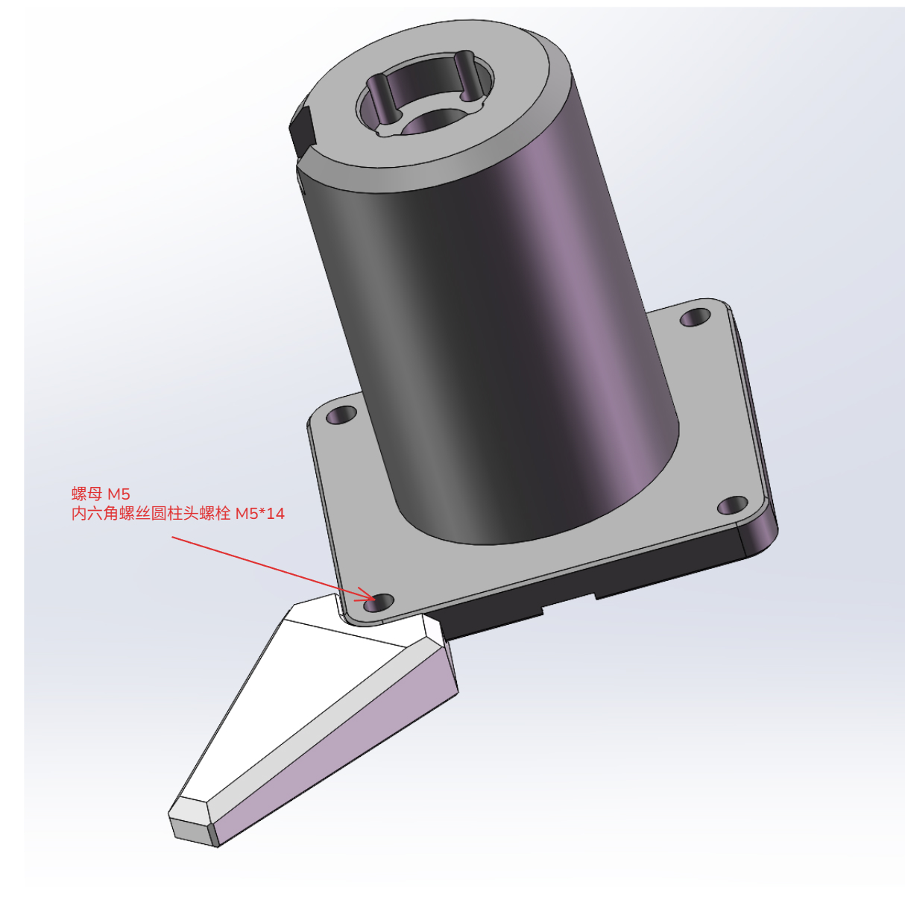
[picture p50: 4. Other/Images/install_04_02.jpg]


____
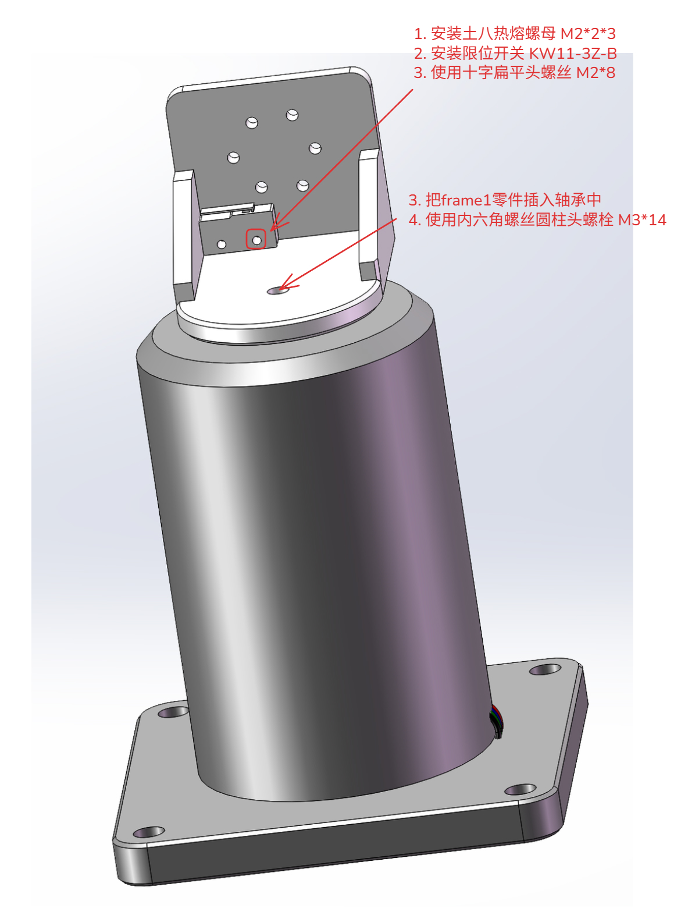
[picture p51: 4. Other/Images/install_05.jpg]


____

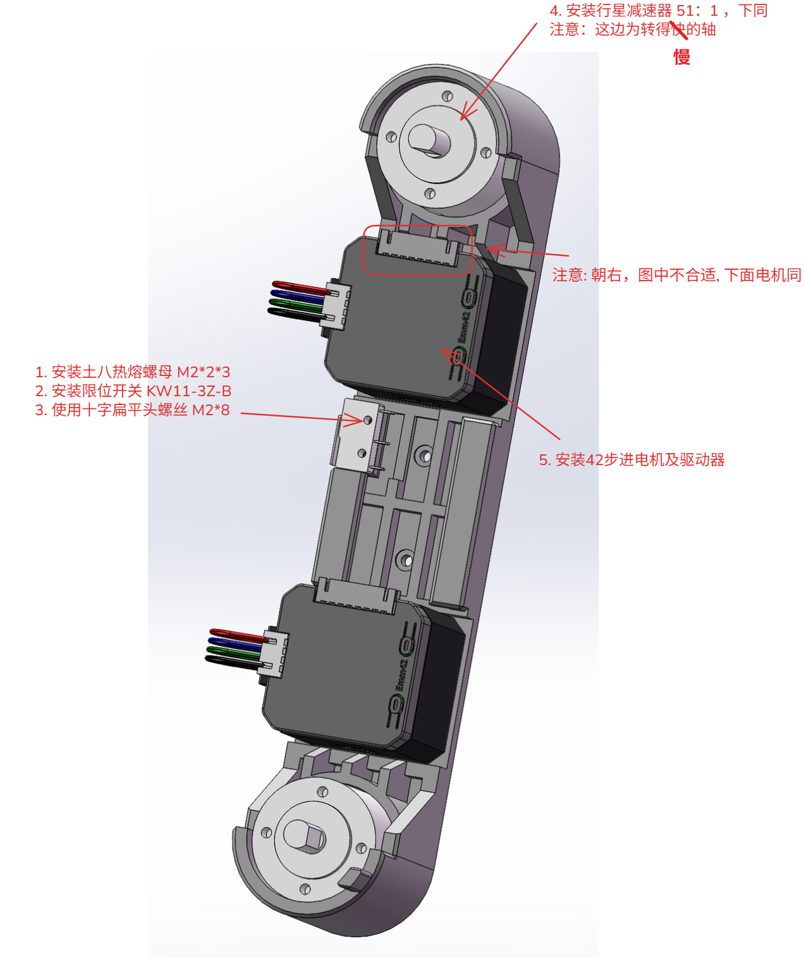
[picture p52: 4. Other/Images/install_06.jpg]


____

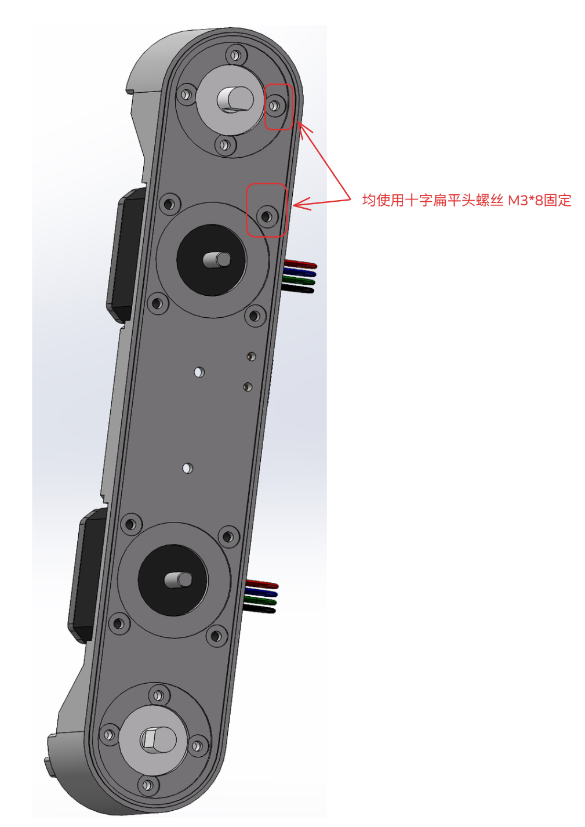
[picture p53: 4. Other/Images/install_07.jpg]


____

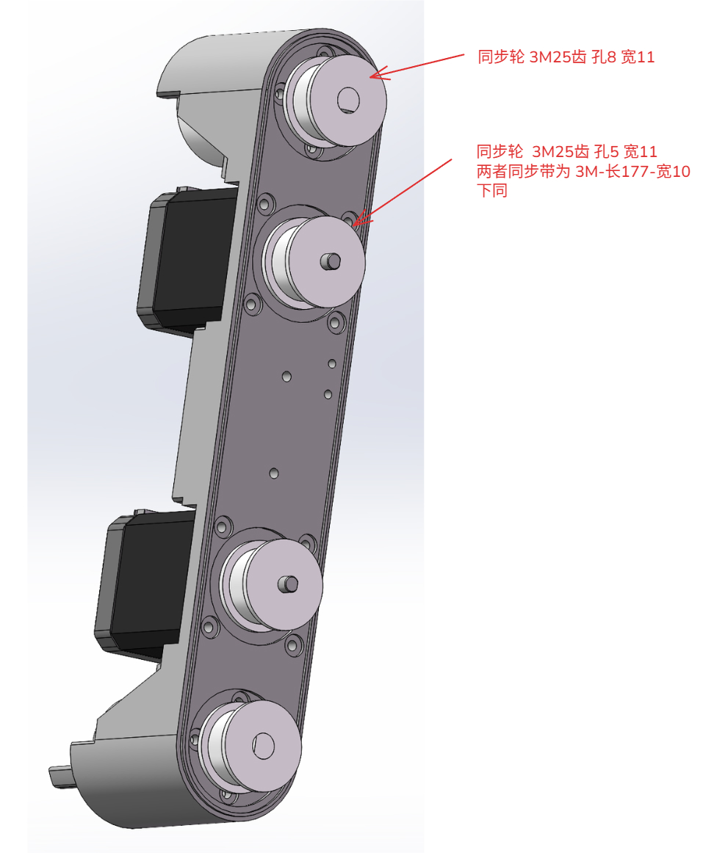
[picture p54: 4. Other/Images/install_08.jpg]


____

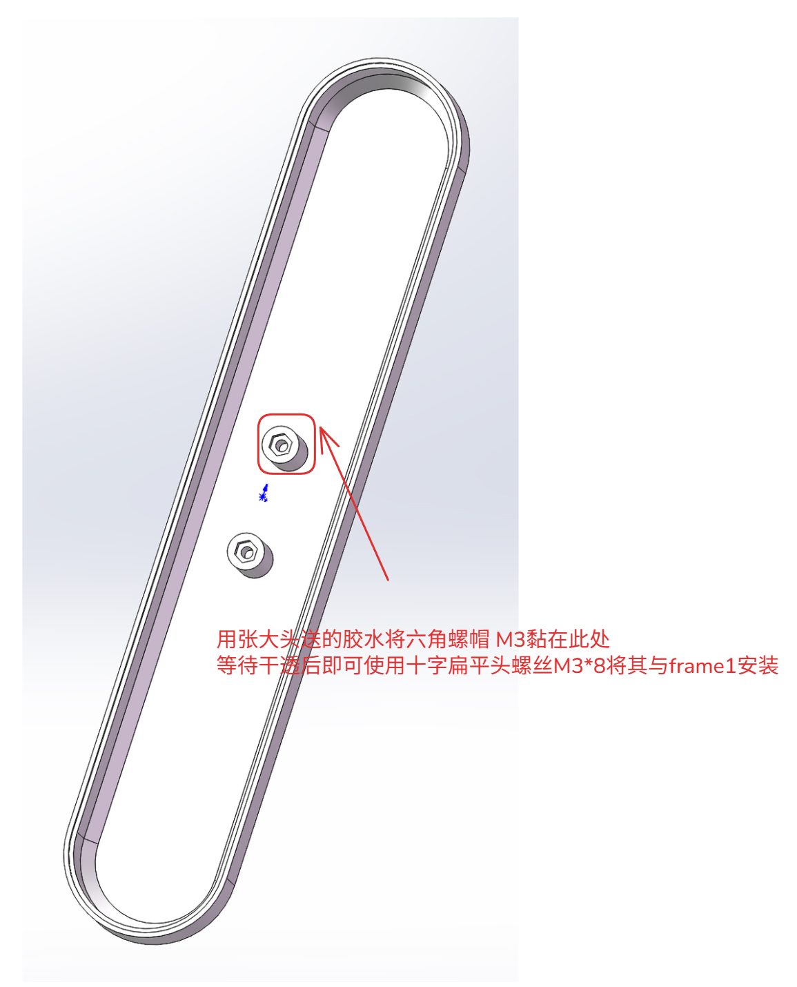
[picture p55: 4. Other/Images/install_09.jpg]


____

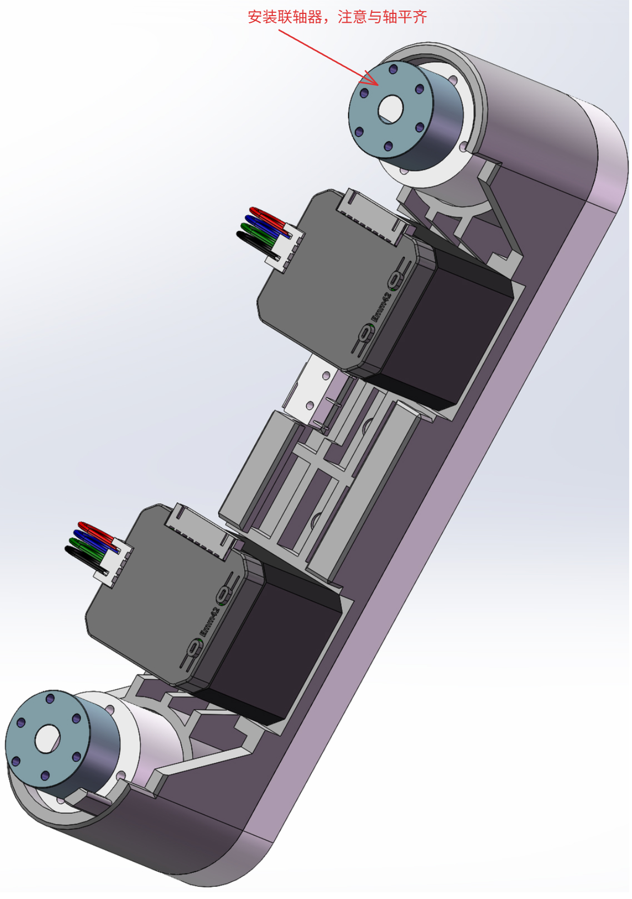
[picture p56: 4. Other/Images/install_10.jpg]


____

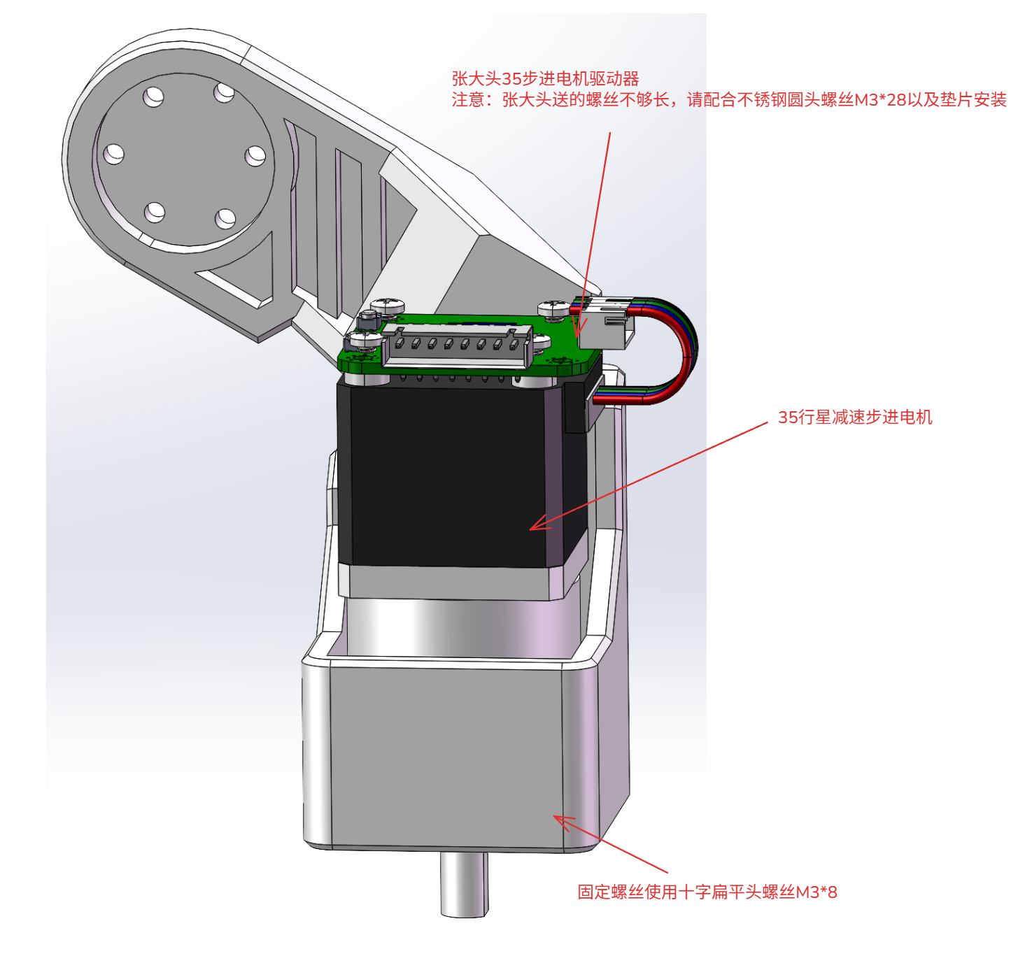
[picture p57: 4. Other/Images/install_11.jpg]


____

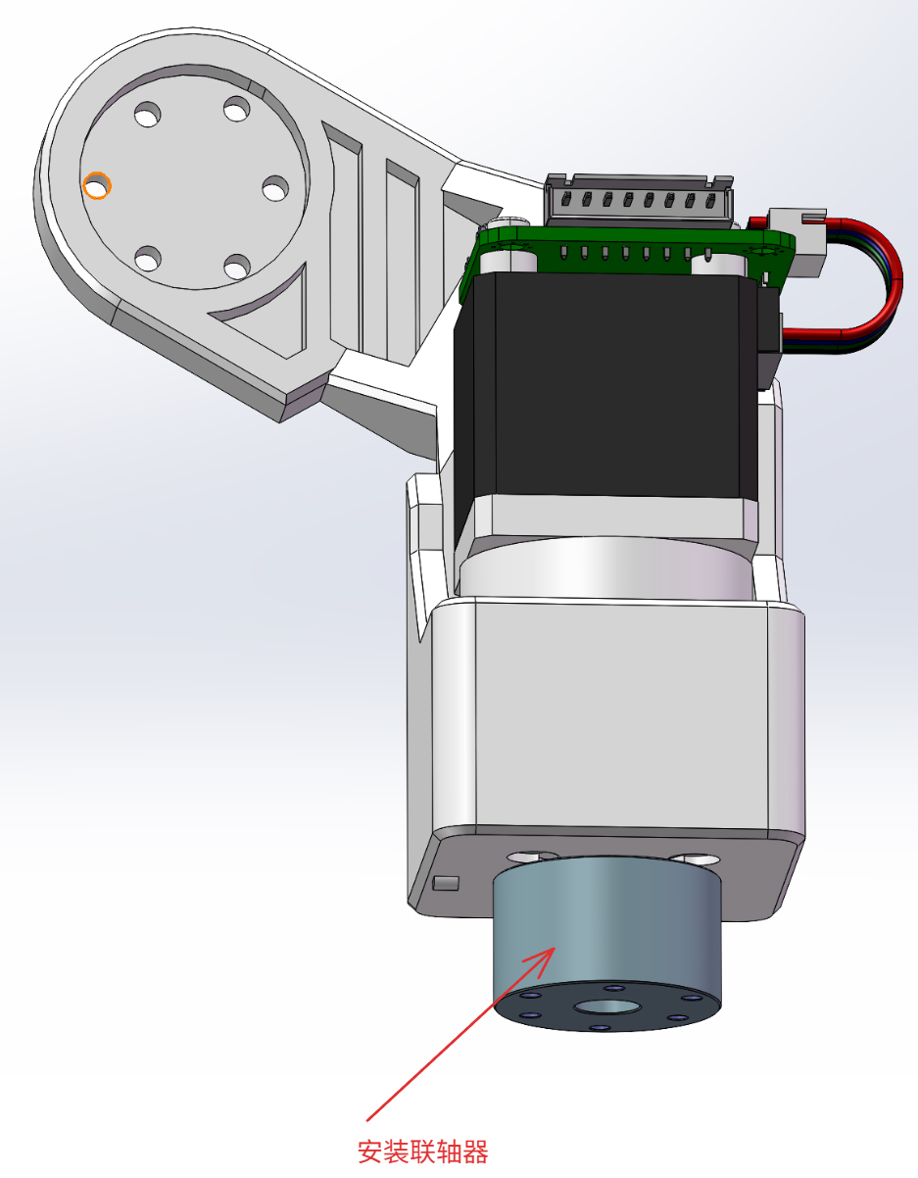
[picture p58: 4. Other/Images/install_12.jpg]


____

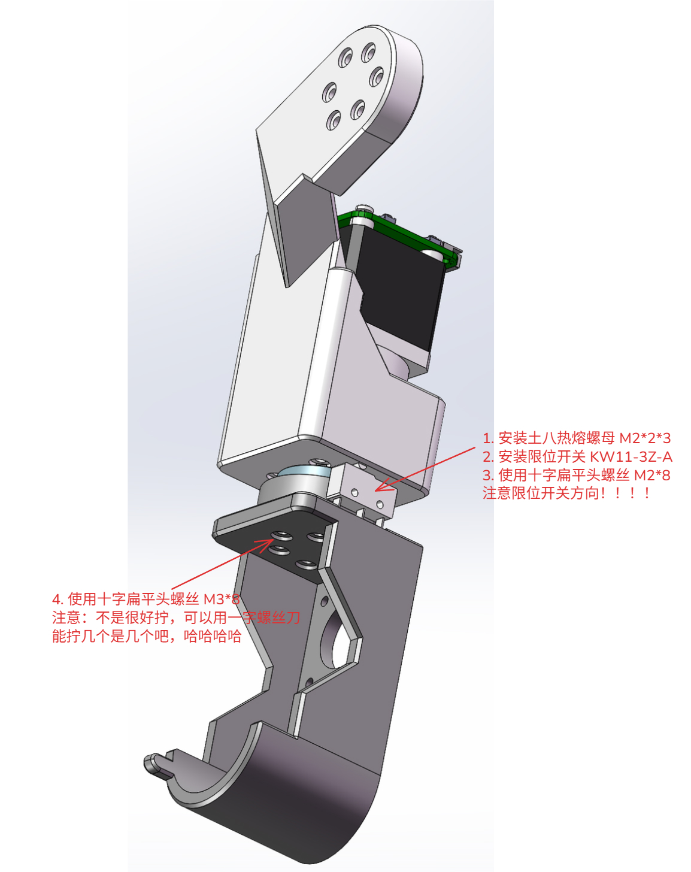
[picture p59: 4. Other/Images/install_13.jpg]


____

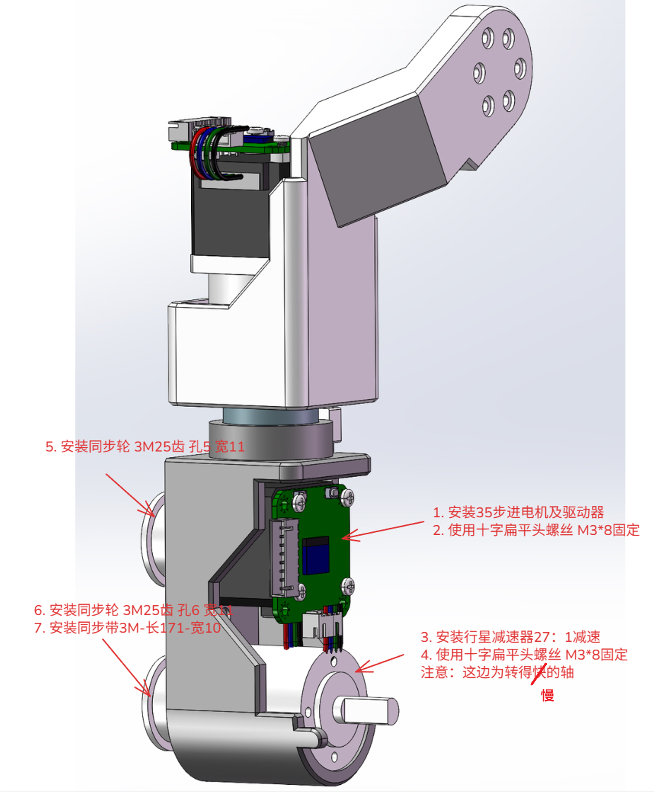
[picture p60: 4. Other/Images/install_14.jpg]


____

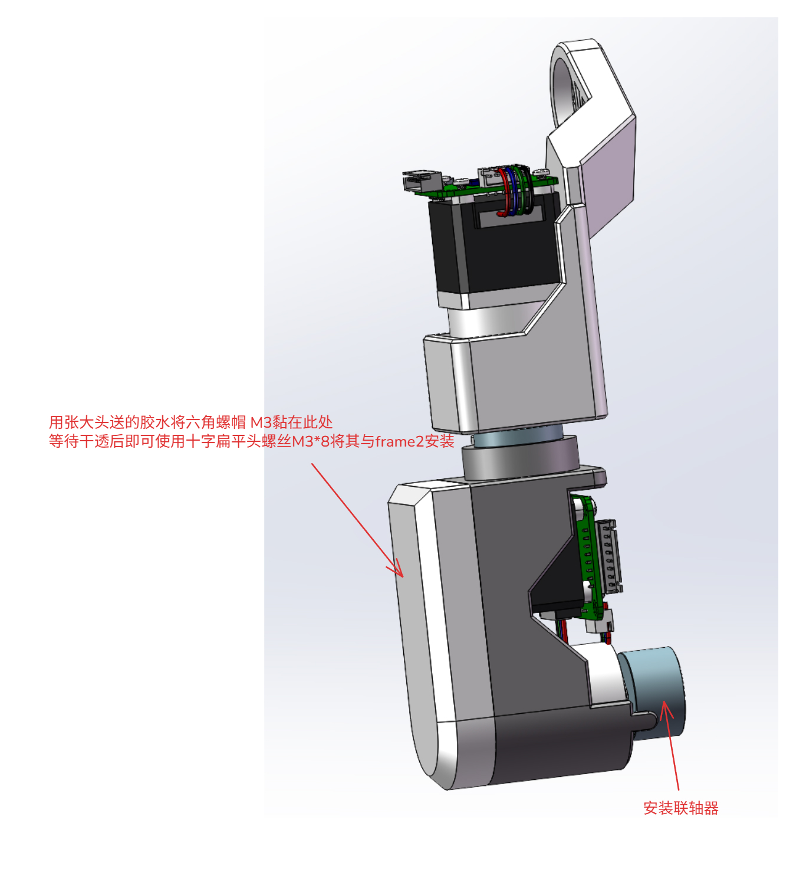
[picture p61: 4. Other/Images/install_15.jpg]


____

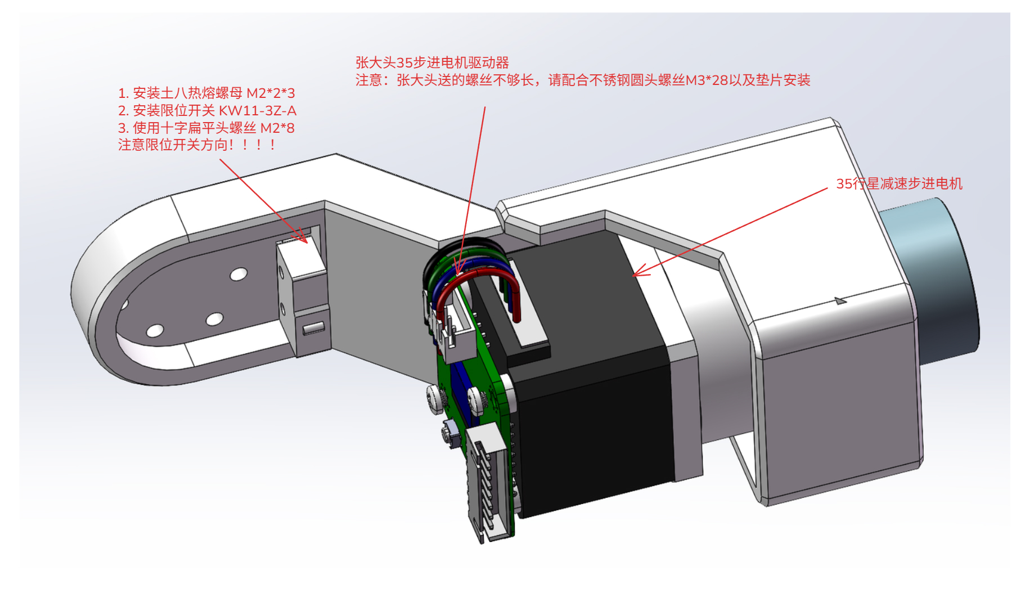
[picture p62: 4. Other/Images/install_16.jpg]


____

### 最后就是将机械臂各关节链接起来！！！安装完毕！！！
