bally65/Archimedes-Hand-/2. Software/robot/Core/Inc/main.h

#define RED_LED_Pin GPIO_PIN_5
#define RED_LED_GPIO_Port GPIOC
#define BLUE_LED_Pin GPIO_PIN_2
#define BLUE_LED_GPIO_Port GPIOB
#define JOINT_LIMIT_1_Pin GPIO_PIN_0
#define JOINT_LIMIT_1_GPIO_Port GPIOD
#define JOINT_LIMIT_1_EXTI_IRQn EXTI0_IRQn
#define JOINT_LIMIT_2_Pin GPIO_PIN_1
#define JOINT_LIMIT_2_GPIO_Port GPIOD
#define JOINT_LIMIT_2_EXTI_IRQn EXTI1_IRQn
#define JOINT_LIMIT_3_Pin GPIO_PIN_2
#define JOINT_LIMIT_3_GPIO_Port GPIOD
#define JOINT_LIMIT_3_EXTI_IRQn EXTI2_IRQn
#define JOINT_LIMIT_4_Pin GPIO_PIN_3
#define JOINT_LIMIT_4_GPIO_Port GPIOD
#define JOINT_LIMIT_4_EXTI_IRQn EXTI3_IRQn
#define JOINT_LIMIT_5_Pin GPIO_PIN_4
#define JOINT_LIMIT_5_GPIO_Port GPIOD
#define JOINT_LIMIT_5_EXTI_IRQn EXTI4_IRQn
#define JOINT_LIMIT_6_Pin GPIO_PIN_5
#define JOINT_LIMIT_6_GPIO_Port GPIOD
#define JOINT_LIMIT_6_EXTI_IRQn EXTI9_5_IRQn
