bally65/Archimedes-Hand-/2. Software/robot/Core/Src/usart.c

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
/* Includes ------------------------------------------------------------------*/
#include "usart.h"

/* USER CODE BEGIN 0 */
#include "stdio.h"
#include "robot.h"
#include "string.h"
#include <stdarg.h>

// UART1 接收缓冲区
#define UART1_RX_BUFF_SIZE 128 // 定义接收缓冲区大小
static char uart1_rx_buff[UART1_RX_BUFF_SIZE + SAFE_BUFF_SIZE] = {0}; // 定义接收缓冲区
static uint32_t uart1_rx_pos = 0; // 定义接收位置

// UART3 接收缓冲区
volatile char uart3_rx_buff[UART3_RX_BUFF_SIZE + SAFE_BUFF_SIZE] = {0};
volatile uint32_t uart3_rx_pos = 0;

/* USER CODE END 0 */

UART_HandleTypeDef huart1;
UART_HandleTypeDef huart3;
DMA_HandleTypeDef hdma_usart3_rx;

/* USART1 init function */

void MX_USART1_UART_Init(void)
{

  huart1.Instance = USART1;
  huart1.Init.BaudRate = 115200;
  huart1.Init.WordLength = UART_WORDLENGTH_8B;
  huart1.Init.StopBits = UART_STOPBITS_1;
  huart1.Init.Parity = UART_PARITY_NONE;
  huart1.Init.Mode = UART_MODE_TX_RX;
  huart1.Init.HwFlowCtl = UART_HWCONTROL_NONE;
  huart1.Init.OverSampling = UART_OVERSAMPLING_16;
  if (HAL_UART_Init(&huart1) != HAL_OK)
  {
    Error_Handler();
  }
  /* USER CODE BEGIN USART1_Init 2 */
  HAL_UART_Receive_IT(&huart1, (uint8_t *)uart1_rx_buff, 1); // 启动串口接收中断
  /* USER CODE END USART1_Init 2 */

}
/* USART3 init function */

void MX_USART3_UART_Init(void)
{

  huart3.Instance = USART3;
  huart3.Init.BaudRate = 115200;
  huart3.Init.WordLength = UART_WORDLENGTH_8B;
  huart3.Init.StopBits = UART_STOPBITS_1;
  huart3.Init.Parity = UART_PARITY_NONE;
  huart3.Init.Mode = UART_MODE_TX_RX;
  huart3.Init.HwFlowCtl = UART_HWCONTROL_NONE;
  huart3.Init.OverSampling = UART_OVERSAMPLING_16;
  if (HAL_UART_Init(&huart3) != HAL_OK)
  {
    Error_Handler();
  }
}

void HAL_UART_MspInit(UART_HandleTypeDef* uartHandle)
{

  GPIO_InitTypeDef GPIO_InitStruct = {0};
  if(uartHandle->Instance==USART1)
  {
    /* USART1 clock enable */
    __HAL_RCC_USART1_CLK_ENABLE();

    __HAL_RCC_GPIOA_CLK_ENABLE();
    /**USART1 GPIO Configuration
    PA9     ------> USART1_TX
    PA10     ------> USART1_RX
    */
    GPIO_InitStruct.Pin = GPIO_PIN_9|GPIO_PIN_10;
    GPIO_InitStruct.Mode = GPIO_MODE_AF_PP;
    GPIO_InitStruct.Pull = GPIO_NOPULL;
    GPIO_InitStruct.Speed = GPIO_SPEED_FREQ_VERY_HIGH;
    GPIO_InitStruct.Alternate = GPIO_AF7_USART1;
    HAL_GPIO_Init(GPIOA, &GPIO_InitStruct);

    /* USART1 interrupt Init */
    HAL_NVIC_SetPriority(USART1_IRQn, 6, 0);
    HAL_NVIC_EnableIRQ(USART1_IRQn);
  }
  else if(uartHandle->Instance==USART3)
  {
    /* USART3 clock enable */
    __HAL_RCC_USART3_CLK_ENABLE();

    __HAL_RCC_GPIOB_CLK_ENABLE();
    /**USART3 GPIO Configuration
    PB10     ------> USART3_TX
    PB11     ------> USART3_RX
    */
    GPIO_InitStruct.Pin = GPIO_PIN_10|GPIO_PIN_11;
    GPIO_InitStruct.Mode = GPIO_MODE_AF_PP;
    GPIO_InitStruct.Pull = GPIO_NOPULL;
    GPIO_InitStruct.Speed = GPIO_SPEED_FREQ_VERY_HIGH;
    GPIO_InitStruct.Alternate = GPIO_AF7_USART3;
    HAL_GPIO_Init(GPIOB, &GPIO_InitStruct);

    /* USART3 DMA Init */
    /* USART3_RX Init */
    hdma_usart3_rx.Instance = DMA1_Stream1;
    hdma_usart3_rx.Init.Channel = DMA_CHANNEL_4;
    hdma_usart3_rx.Init.Direction = DMA_PERIPH_TO_MEMORY;
    hdma_usart3_rx.Init.PeriphInc = DMA_PINC_DISABLE;
    hdma_usart3_rx.Init.MemInc = DMA_MINC_ENABLE;
    hdma_usart3_rx.Init.PeriphDataAlignment = DMA_PDATAALIGN_BYTE;
    hdma_usart3_rx.Init.MemDataAlignment = DMA_MDATAALIGN_BYTE;
    hdma_usart3_rx.Init.Mode = DMA_CIRCULAR;
    hdma_usart3_rx.Init.Priority = DMA_PRIORITY_HIGH;
    hdma_usart3_rx.Init.FIFOMode = DMA_FIFOMODE_DISABLE;
    if (HAL_DMA_Init(&hdma_usart3_rx) != HAL_OK)
    {
      Error_Handler();
    }

    __HAL_LINKDMA(uartHandle,hdmarx,hdma_usart3_rx);

    /* USART3 interrupt Init */
    HAL_NVIC_SetPriority(USART3_IRQn, 6, 0);
    HAL_NVIC_EnableIRQ(USART3_IRQn);
  }
}

void HAL_UART_MspDeInit(UART_HandleTypeDef* uartHandle)
{

  if(uartHandle->Instance==USART1)
  {
    /* Peripheral clock disable */
    __HAL_RCC_USART1_CLK_DISABLE();

    /**USART1 GPIO Configuration
    PA9     ------> USART1_TX
    PA10     ------> USART1_RX
    */
    HAL_GPIO_DeInit(GPIOA, GPIO_PIN_9|GPIO_PIN_10);

    /* USART1 interrupt Deinit */
    HAL_NVIC_DisableIRQ(USART1_IRQn);
  }
  else if(uartHandle->Instance==USART3)
  {
    /* Peripheral clock disable */
    __HAL_RCC_USART3_CLK_DISABLE();

    /**USART3 GPIO Configuration
    PB10     ------> USART3_TX
    PB11     ------> USART3_RX
    */
    HAL_GPIO_DeInit(GPIOB, GPIO_PIN_10|GPIO_PIN_11);

    /* USART3 DMA DeInit */
    HAL_DMA_DeInit(uartHandle->hdmarx);

    /* USART3 interrupt Deinit */
    HAL_NVIC_DisableIRQ(USART3_IRQn);
  }
}

/* USER CODE BEGIN 1 */
void HAL_UART_RxCpltCallback(UART_HandleTypeDef *huart)
{
	if (huart->Instance == USART1) {
		// 处理接收到的数据
		if (uart1_rx_buff[uart1_rx_pos] == '\n') {
          uart1_rx_buff[uart1_rx_pos] = '\0'; // 替换换行符为'\0'
			    robot_cmd_send_from_isr(uart1_rx_buff, CMD_TYPE_UART1);
			    memset(uart1_rx_buff, 0, uart1_rx_pos + 1); // 清空接收缓冲区
			    uart1_rx_pos = 0; // 重置接收位置
		} else {
          uart1_rx_pos += 1;
    }
		HAL_UART_Receive_IT(&huart1, (uint8_t *)&uart1_rx_buff[uart1_rx_pos], 1); // 重新启动串口接收中断
	} else if (huart->Instance == USART3) {
       // 处理接收到的数据
       if (uart3_rx_buff[uart3_rx_pos] == '\n' && uart3_rx_buff[uart3_rx_pos - 1] == '\r') {
           uart3_rx_buff[uart3_rx_pos + 1] = '\0'; // 替换换行符为'\0'
           robot_cmd_send_from_isr(uart3_rx_buff, CMD_TYPE_MQTT); // 处理接收到的数据
           uart3_rx_pos = 0;
           HAL_UART_Receive_IT(&huart3, (uint8_t *)&uart3_rx_buff[uart3_rx_pos], 1);
           return;
       }

       uart3_rx_pos += 1;
       if (uart3_rx_pos >= UART3_RX_BUFF_SIZE) {
           uart3_rx_pos = 0;
       }
       
       HAL_UART_Receive_IT(&huart3, (uint8_t *)&uart3_rx_buff[uart3_rx_pos], 1);
  	}
}

// 安全的printf函数，确保在多任务环境下的线程安全，不支持中断中调用
void safe_printf(const char *format, ...) 
{
  va_list args;
  char buffer[128]; // 根据需要调整缓冲区大小
  va_start(args, format);
  vsnprintf(buffer, sizeof(buffer), format, args);
  va_end(args);
  taskENTER_CRITICAL(); // 进入临界区
  HAL_UART_Transmit(&huart1, (uint8_t *)buffer, strlen(buffer), HAL_MAX_DELAY);
  taskEXIT_CRITICAL(); // 退出临界区
}

void safe_printf_from_isr(const char *format, ...) 
{
    va_list args;
    char buffer[128]; // 根据需要调整缓冲区大小
    va_start(args, format);
    vsnprintf(buffer, sizeof(buffer), format, args);
    va_end(args);
    UBaseType_t saved;
    saved = taskENTER_CRITICAL_FROM_ISR(); // 进入临界区
    HAL_UART_Transmit(&huart1, (uint8_t *)buffer, strlen(buffer), HAL_MAX_DELAY);
    taskEXIT_CRITICAL_FROM_ISR(saved); // 退出临界区
  }
/* USER CODE END 1 */
