bally65/Archimedes-Hand-/2. Software/robot/Core/Inc/can.h

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
/* Define to prevent recursive inclusion -------------------------------------*/
#ifndef __CAN_H__
#define __CAN_H__

#ifdef __cplusplus
extern "C" {
#endif

/* Includes ------------------------------------------------------------------*/
#include "main.h"

/* USER CODE BEGIN Includes */

#include "stdbool.h"

typedef struct {
	__IO CAN_RxHeaderTypeDef CAN_RxMsg;
	__IO uint8_t rxData[32];
	
	__IO CAN_TxHeaderTypeDef CAN_TxMsg;
	__IO uint8_t txData[32];

	__IO bool rxFrameFlag;
}CAN_t;

/* USER CODE END Includes */

extern CAN_HandleTypeDef hcan1;

/* USER CODE BEGIN Private defines */

extern __IO CAN_t can;

/* USER CODE END Private defines */

void MX_CAN1_Init(void);

/* USER CODE BEGIN Prototypes */
void USER_CAN1_Filter_Init(void);
void can_SendCmd(__IO uint8_t *cmd, uint8_t len);
/* USER CODE END Prototypes */

#ifdef __cplusplus
}
#endif

#endif /* __CAN_H__ */
