bally65/Archimedes-Hand-/2. Software/robot/Core/Inc/usart.h

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
/* Define to prevent recursive inclusion -------------------------------------*/
#ifndef __USART_H__
#define __USART_H__

#ifdef __cplusplus
extern "C" {
#endif

/* Includes ------------------------------------------------------------------*/
#include "main.h"

extern UART_HandleTypeDef huart1;

extern UART_HandleTypeDef huart3;

void MX_USART1_UART_Init(void);
void MX_USART3_UART_Init(void);

/* USER CODE BEGIN Prototypes */
void safe_printf(const char *format, ...);
void safe_printf_from_isr(const char *format, ...);

#define LOG(format, ...) safe_printf(format, ##__VA_ARGS__)
#define LOG_FROM_ISR(format, ...) safe_printf_from_isr(format, ##__VA_ARGS__)
#define SAFE_BUFF_SIZE 2

#define UART3_RX_BUFF_SIZE 512
extern UART_HandleTypeDef huart3;
extern volatile char uart3_rx_buff[UART3_RX_BUFF_SIZE + SAFE_BUFF_SIZE];
extern volatile uint32_t uart3_rx_pos;
/* USER CODE END Prototypes */

#ifdef __cplusplus
}
#endif

#endif /* __USART_H__ */
