bally65/Archimedes-Hand-/(commit log)

2026-02-07 Initial commit: Project Archimedes' Hand - Integrating Zero Arm with Screw Propulsion Platform
    [1mm垫片.STEP, 3d_printing_all.3mf, 42XG二级减速.SLDASM, 42XG二级减速.step, BOM.xlsx, D-H.xlsx, URDF42XG二级减速.SLDASM, URDFZDT_X42_L40Motor.SLDASM]
2026-02-07 sim: Task 1 - prepare solid manifold screw STL for OpenFOAM
    [screw.stl]
2026-02-08 Update: Added all-terrain sediment simulation matrix and initial OpenFOAM config
    [screw_convexFeaturePts.obj, screw_edgeDirections.obj, screw_edgeMesh.obj, screw_externalEdges.obj]
2026-02-08 Initialize Archimedes Hand mobile platform: screw propulsion models, MuJoCo simulation environment, and unified controller
    [archimedes_hand_mujoco.xml, base_plate.stl, screw_left.stl, screw_right.stl]
2026-02-11 feat: complete whole-body coordination training and multi-terrain env
    [archimedes_hand_mujoco.xml, base_plate.stl, base_plate_optimized.stl, robot_arm_mujoco.xml, screw_left.stl, screw_right.stl]
2026-02-13 fix: improve MuJoCo physics stability for large-scale 100m challenge
    [archimedes_hand_mujoco.xml]
2026-02-13 feat: optimize 3D screw modeling with tapered ends and industrial specs
    [archimedes_hand_mujoco.xml, screw_left.stl, screw_right.stl]
2026-02-13 fix: massive mass bug in base plate and recalibrate physics for 100m run
    [archimedes_hand_mujoco.xml]
2026-02-13 fix: resolve starting collision explosion and stabilize physics for 100m run
    [archimedes_hand_mujoco.xml]
2026-02-13 feat: add URDF skeleton and Isaac Lab training template for future migration
    [archimedes_hand.urdf]
2026-02-15 Update: Archimedes' Hand V4.0 Terrain-Aware Prediction Model & Sticky Mud Training logs
    [archimedes_hand_mujoco.xml]
