bally65/Archimedes-Hand-/(notices)

Notices in the files:
2. Software/robot/Core/Inc/main.h:
Copyright (c) 2025 STMicroelectronics.
All rights reserved.
This software is licensed under terms that can be found in the LICENSE file
